simonwaid/particle_detector/20220615103611.md

Slide 2, line 2: SiC instead of Sic Next steps instead of Next Steps

Why does the CCE of iradiated samples not level off? Slide 11/12?

Slice 13 2.7 kHz
