simonwaid/particle_detector/xschem/comp/comp_amp_20db_no_cmm.pdf

# comp_amp_20db_no_cmm.sch

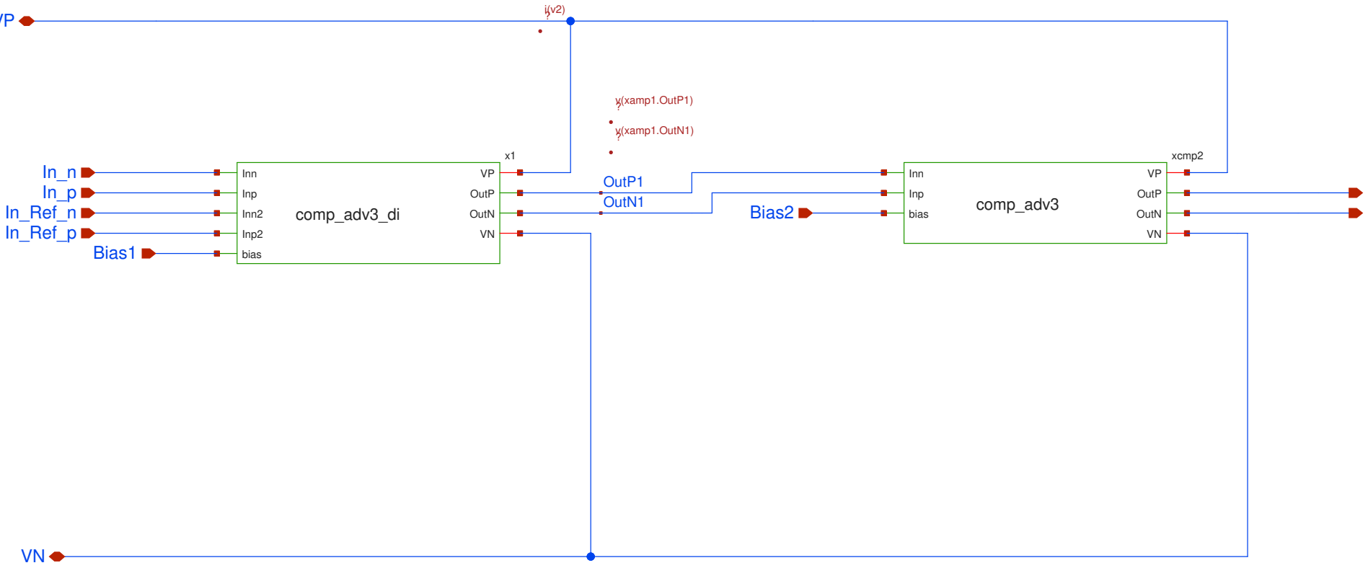
[picture p4: figure]
OutP1 OutN1; Bias1; Bias2; In_Ref_n In_Ref_p; v(xamp1.OutP1); v(xamp1.OutN1); comp_adv3; xcmp2; OutP; OutN; Inn; Inp; bias; comp_adv3_di; Inn2; Inp2

VP

# out_p out_n
