simonwaid/particle_detector/xschem/comp/comp_amp_di_40db_no_cmm.pdf

# comp_amp_di_40db_no_cmm.sch

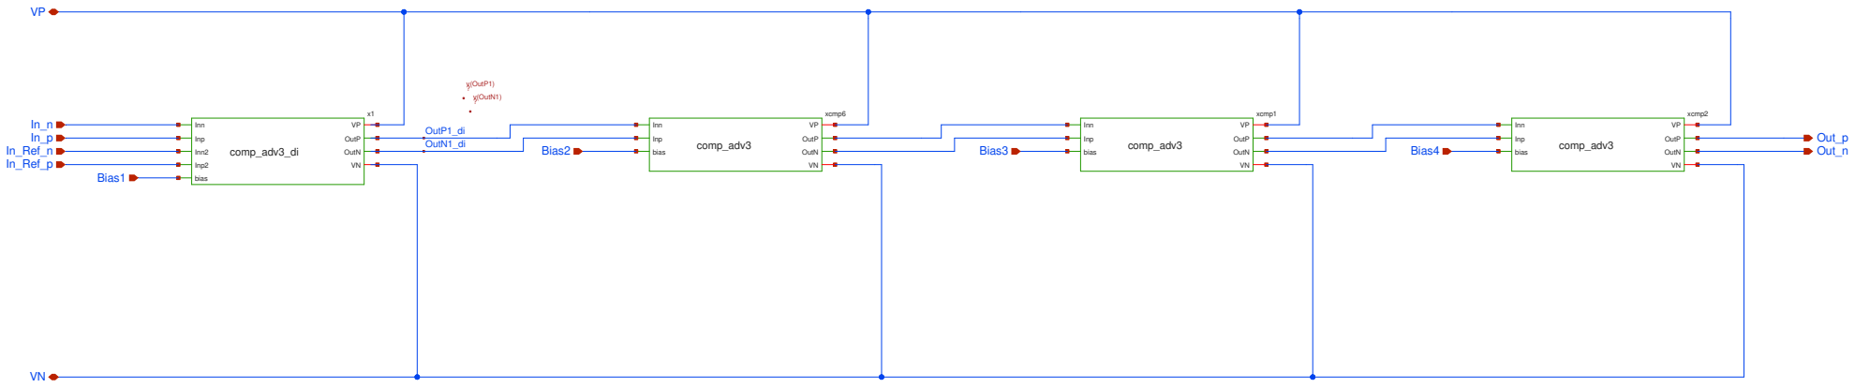
[picture p5: figure]
OutP1_di OutN1_di; Out_pIn_p; Bias1; Bias2; Out_nBias3; Bias4In_Ref_n; In_Ref_p; v(OutP1); v(OutN1); comp_adv3; xcmp6; OutP; OutN; Inn; Inp; bias; xcmp1; xcmp2; comp_adv3_di; Inn2; Inp2
