simonwaid/particle_detector/docs/source/blocks.png

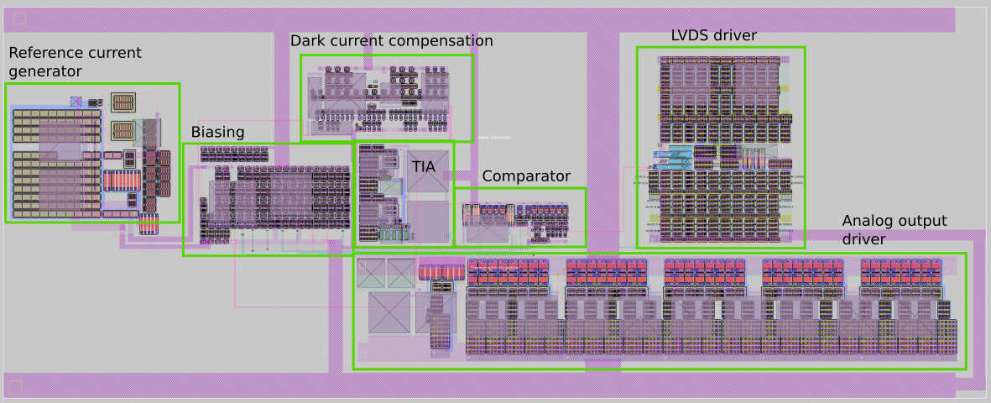
docs/source/blocks.png
