simonwaid/particle_detector/xschem/comp/comp.png

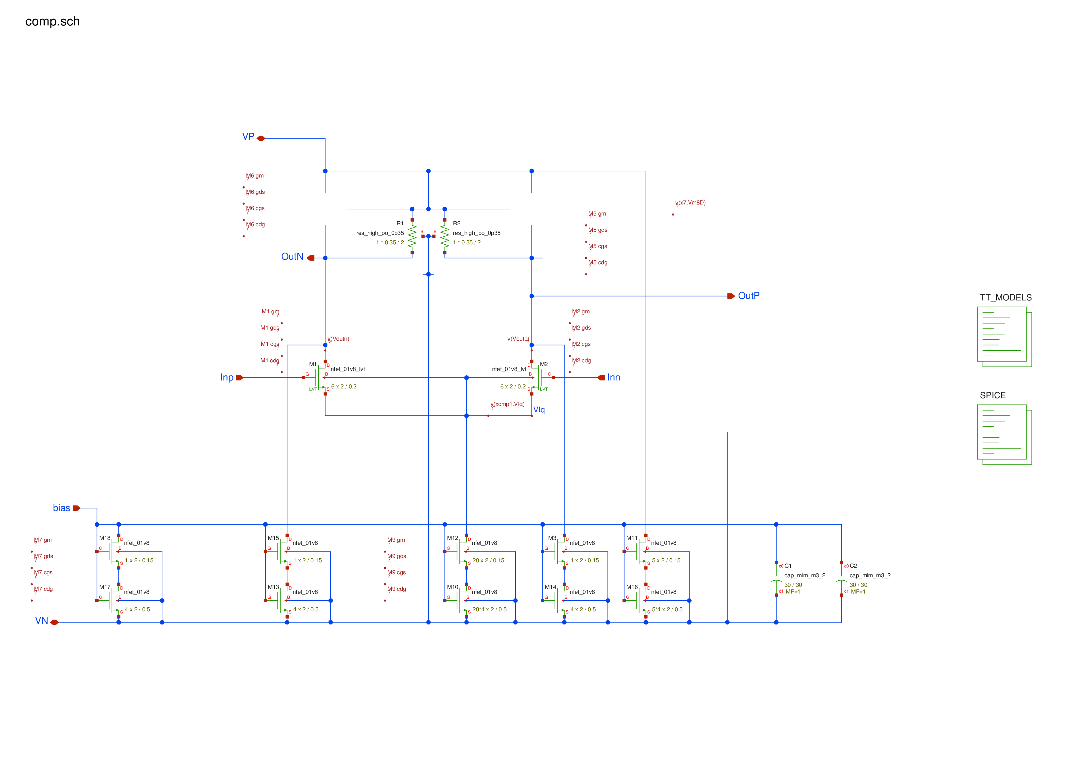
xschem/comp/comp.png
