simonwaid/particle_detector/xschem/comp/comp_adv2.png

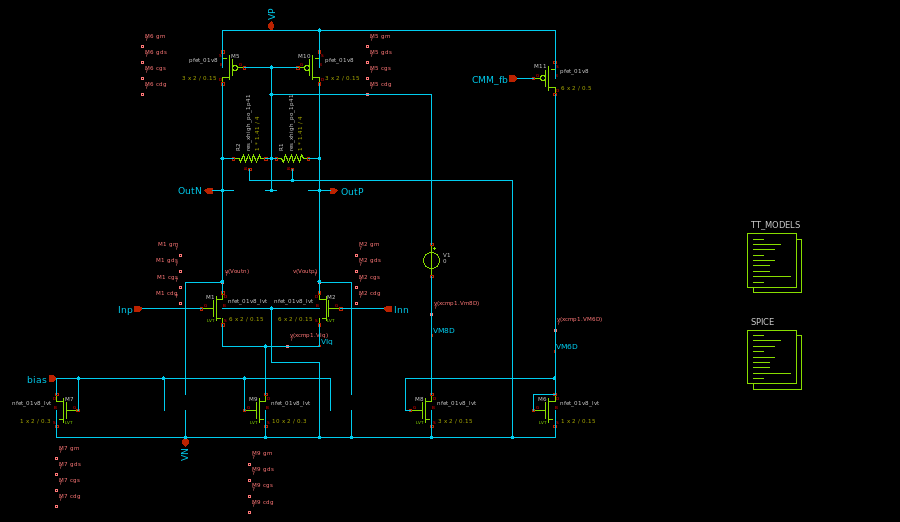
xschem/comp/comp_adv2.png
