simonwaid/particle_detector/xschem/comp/comp_adv3.png

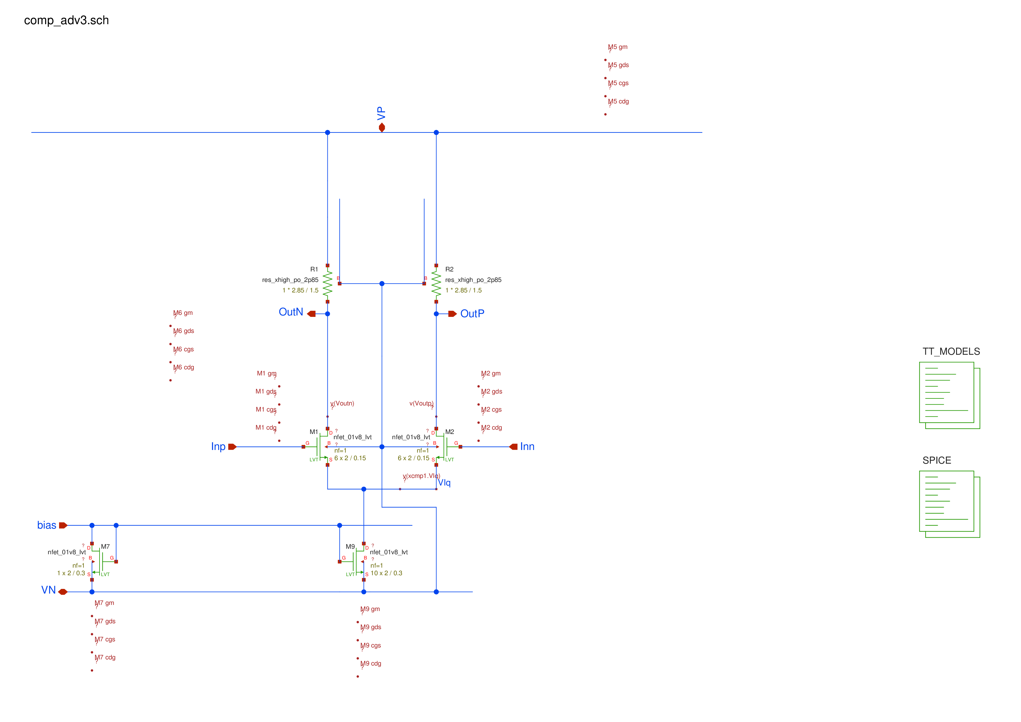
xschem/comp/comp_adv3.png
