simonwaid/particle_detector/xschem/comp/comp_adv3_di.png

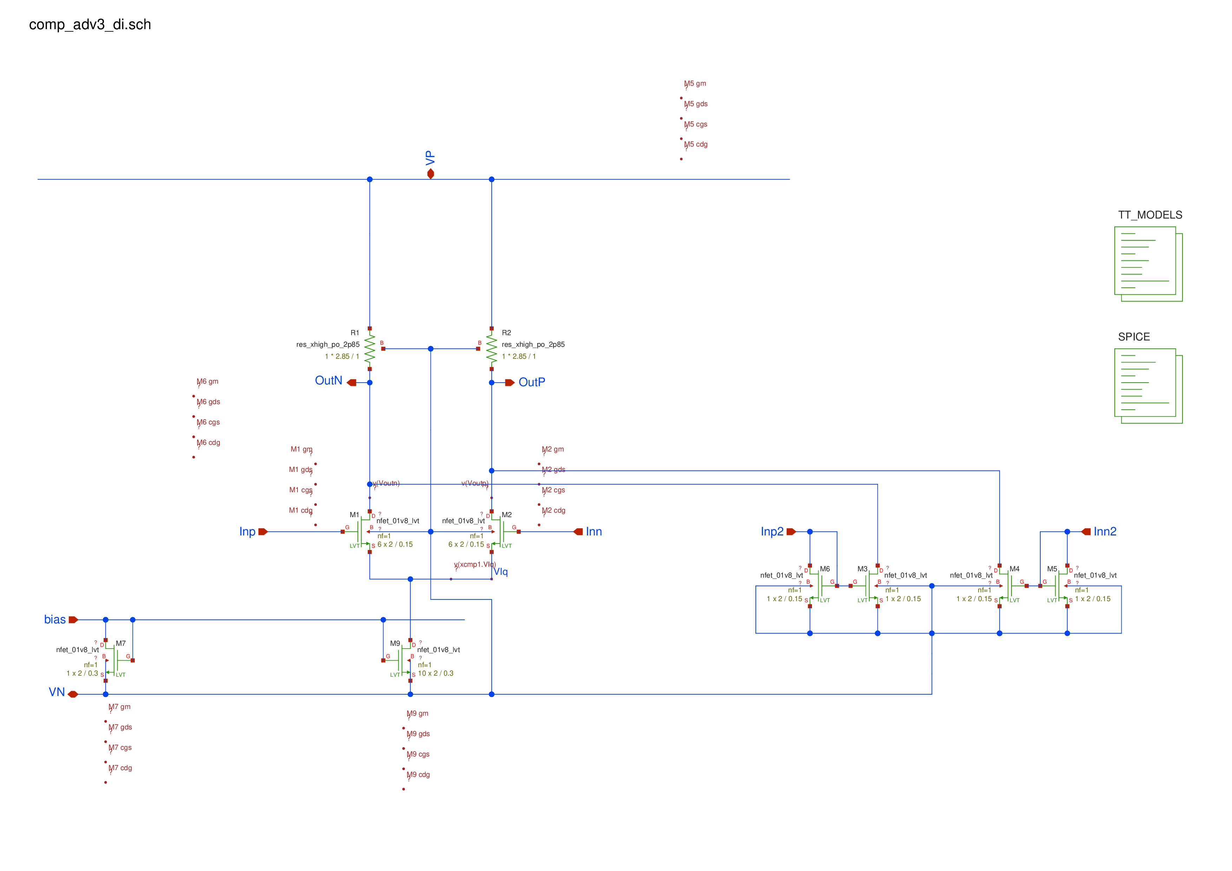
xschem/comp/comp_adv3_di.png
