simonwaid/particle_detector/xschem/comp/comp_adv.png

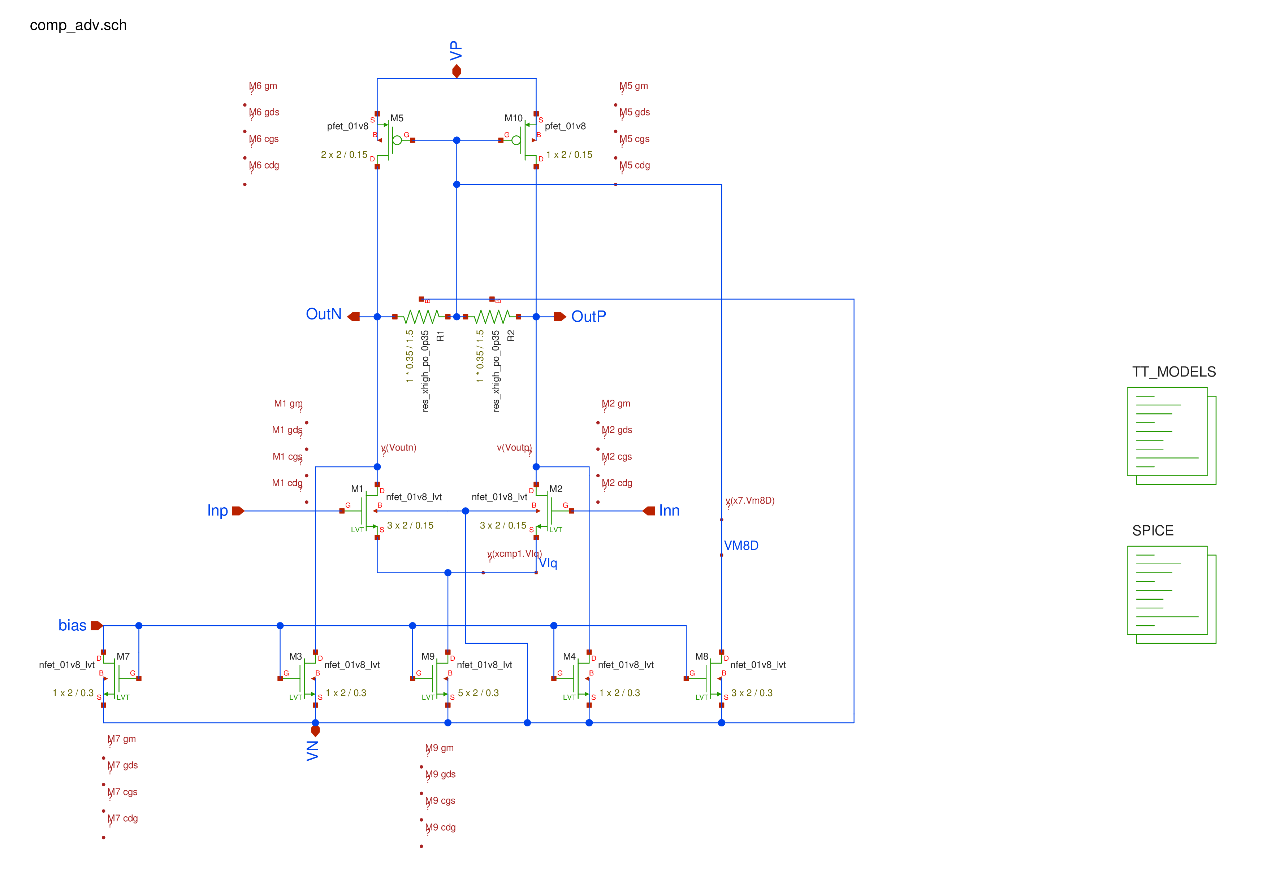
xschem/comp/comp_adv.png
