simonwaid/particle_detector/xschem/comp/comp_amp_20db.png

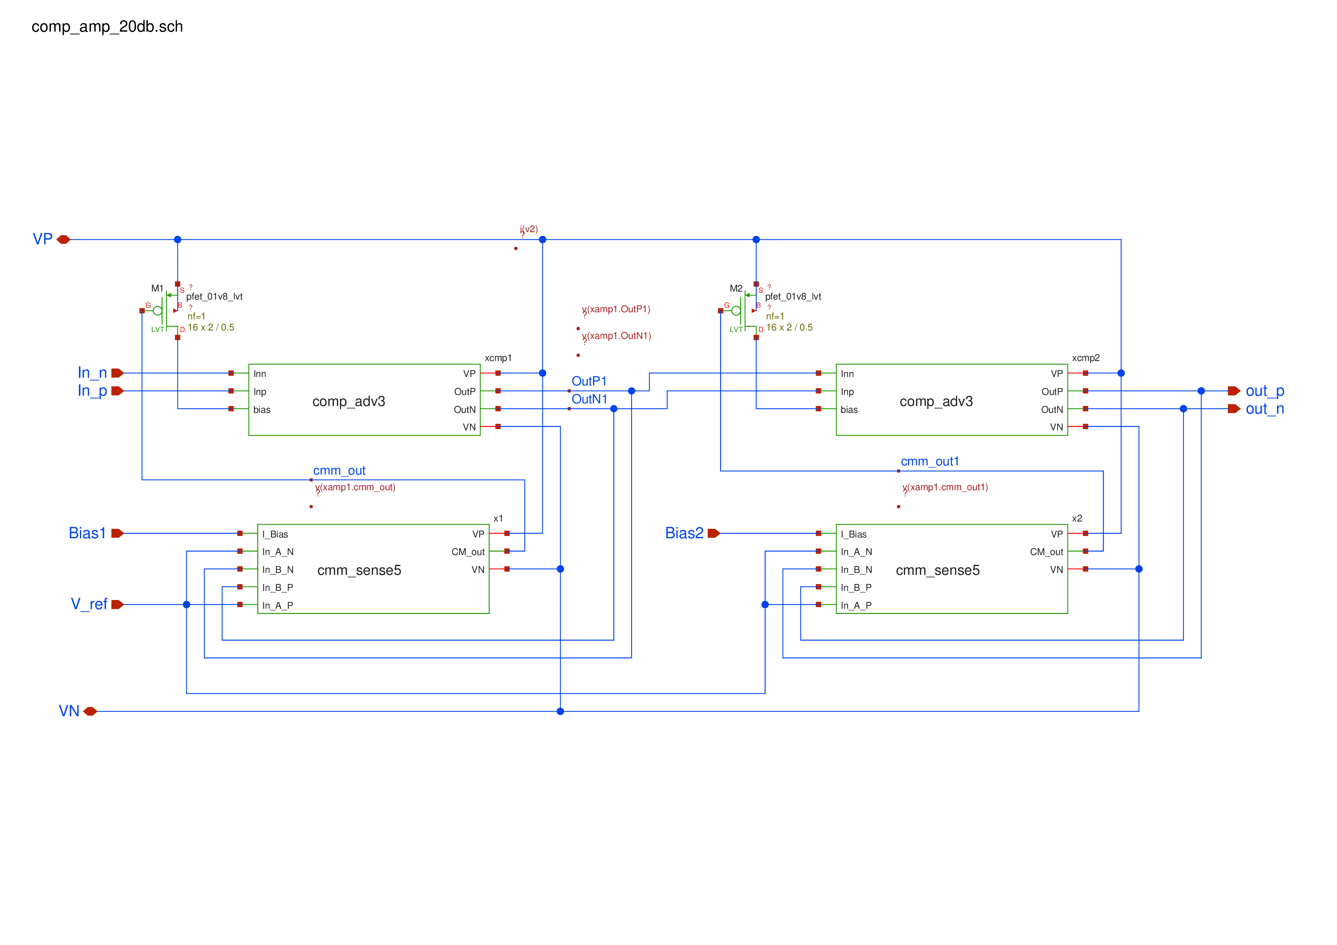
xschem/comp/comp_amp_20db.png
