simonwaid/particle_detector/xschem/comp/comp_amp_20db_no_cmm.png

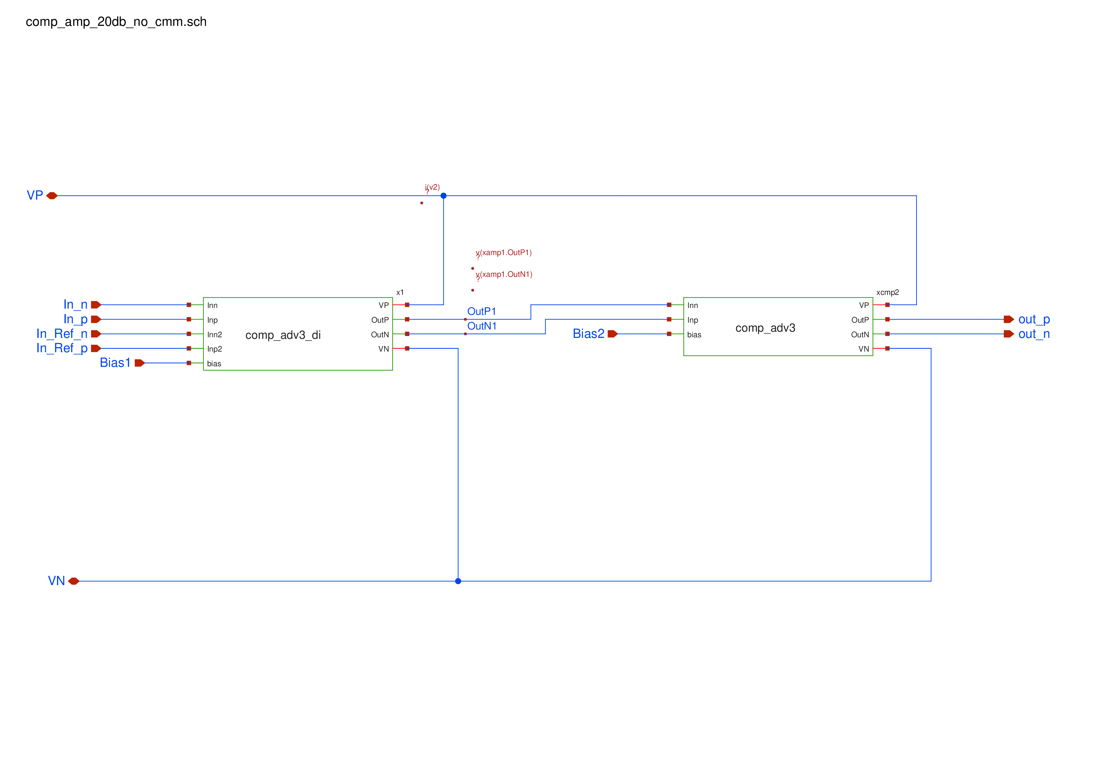
xschem/comp/comp_amp_20db_no_cmm.png
