simonwaid/particle_detector/xschem/comp/comp_amp_di_40db.png

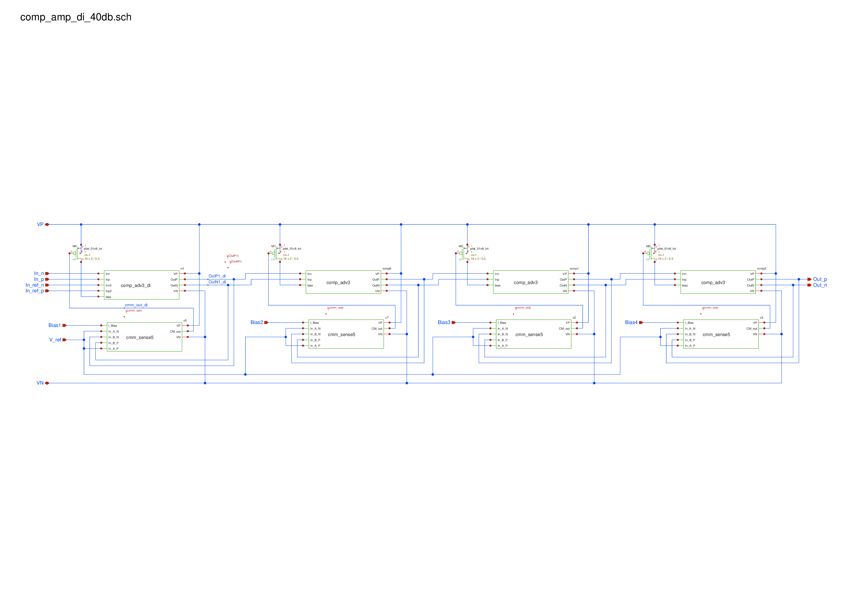
xschem/comp/comp_amp_di_40db.png
