simonwaid/particle_detector/xschem/comp/comp_amp_di_40db_no_cmm.png

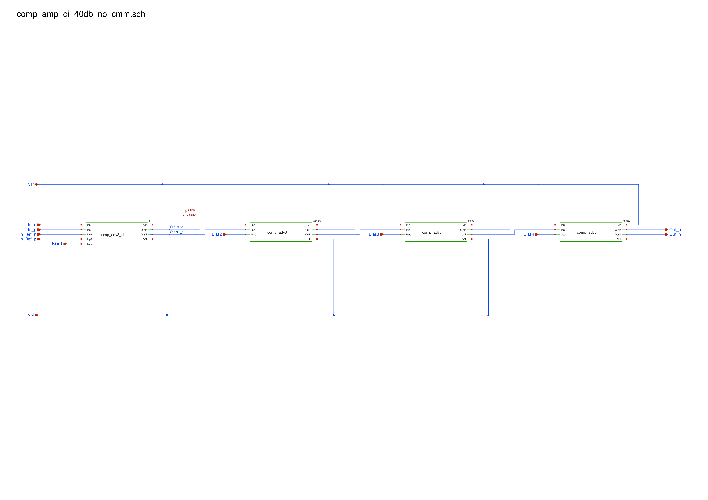
xschem/comp/comp_amp_di_40db_no_cmm.png
