simonwaid/particle_detector/xschem/comp/comp_casc2.png

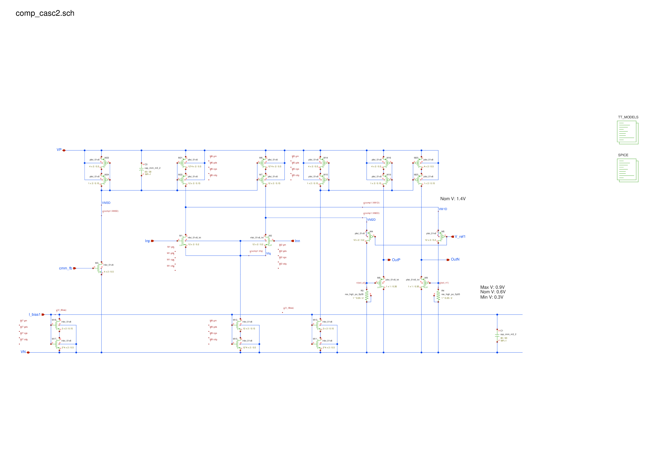
xschem/comp/comp_casc2.png
