simonwaid/particle_detector/xschem/comp/comp_casc.png

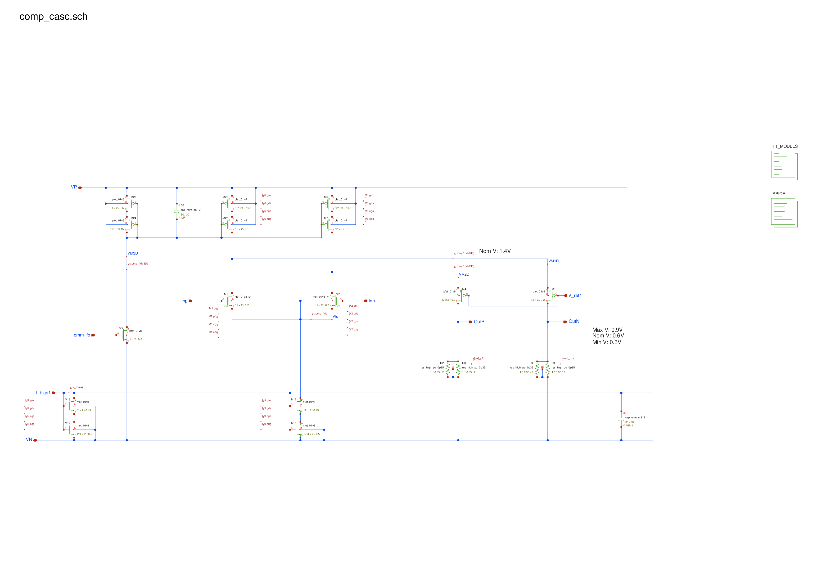
xschem/comp/comp_casc.png
