simonwaid/particle_detector/xschem/comp/comp_casc_p.png

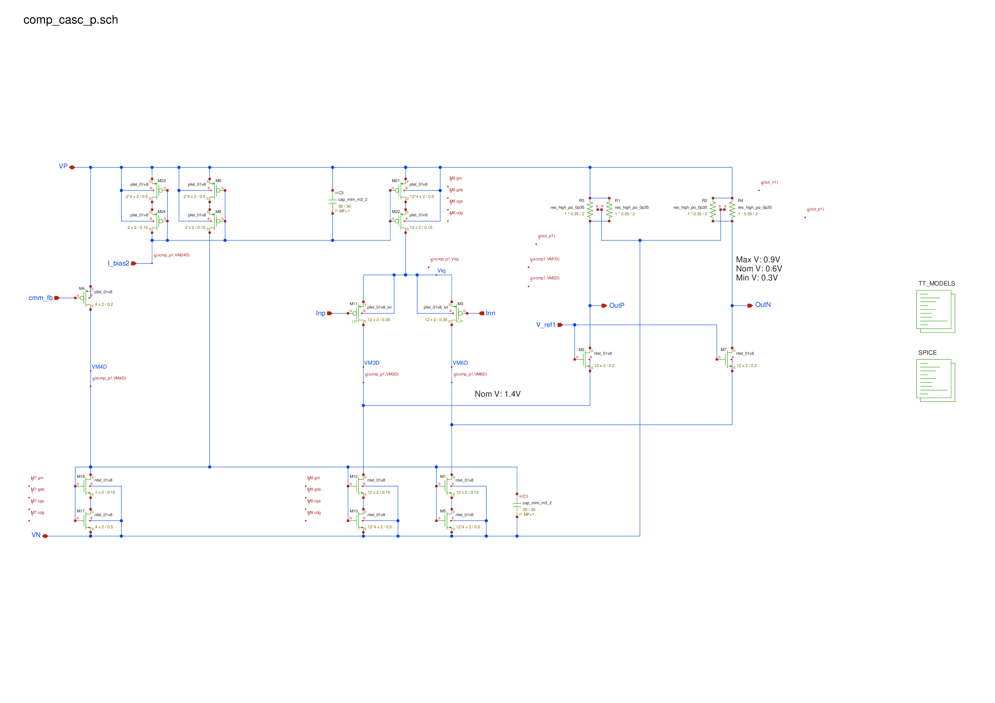
xschem/comp/comp_casc_p.png
