simonwaid/particle_detector/xschem/comp/comp_complete.png

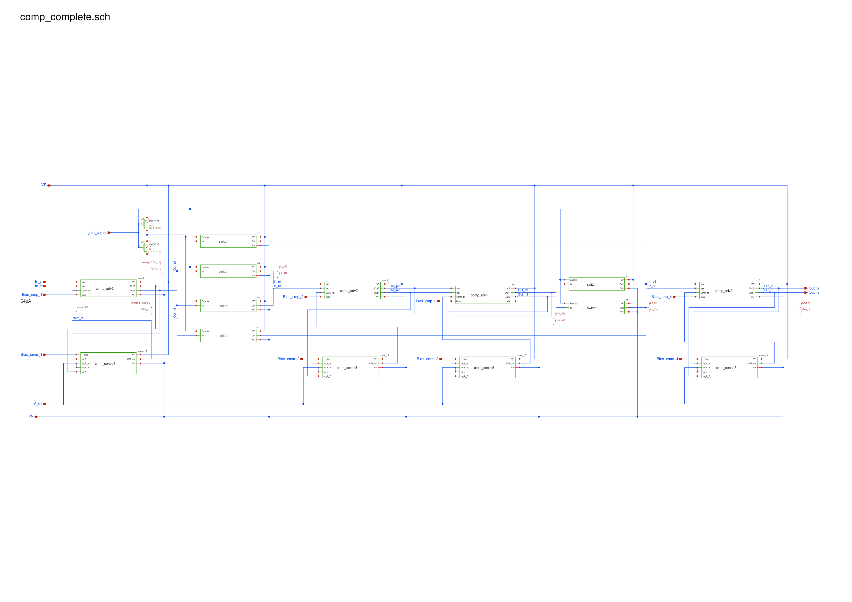
xschem/comp/comp_complete.png
