simonwaid/particle_detector/xschem/comp/comp_to_logic.png

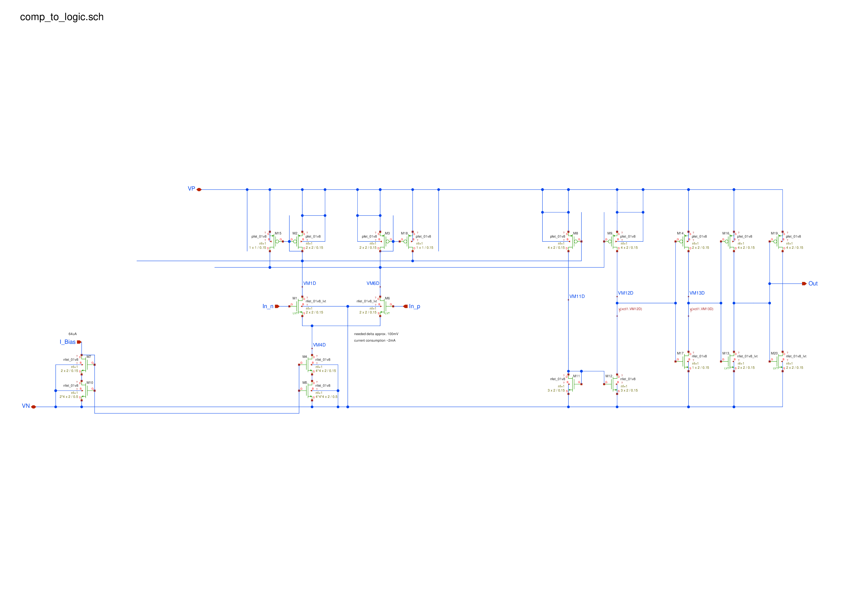
xschem/comp/comp_to_logic.png
