simonwaid/particle_detector/xschem/comp/compEn.png

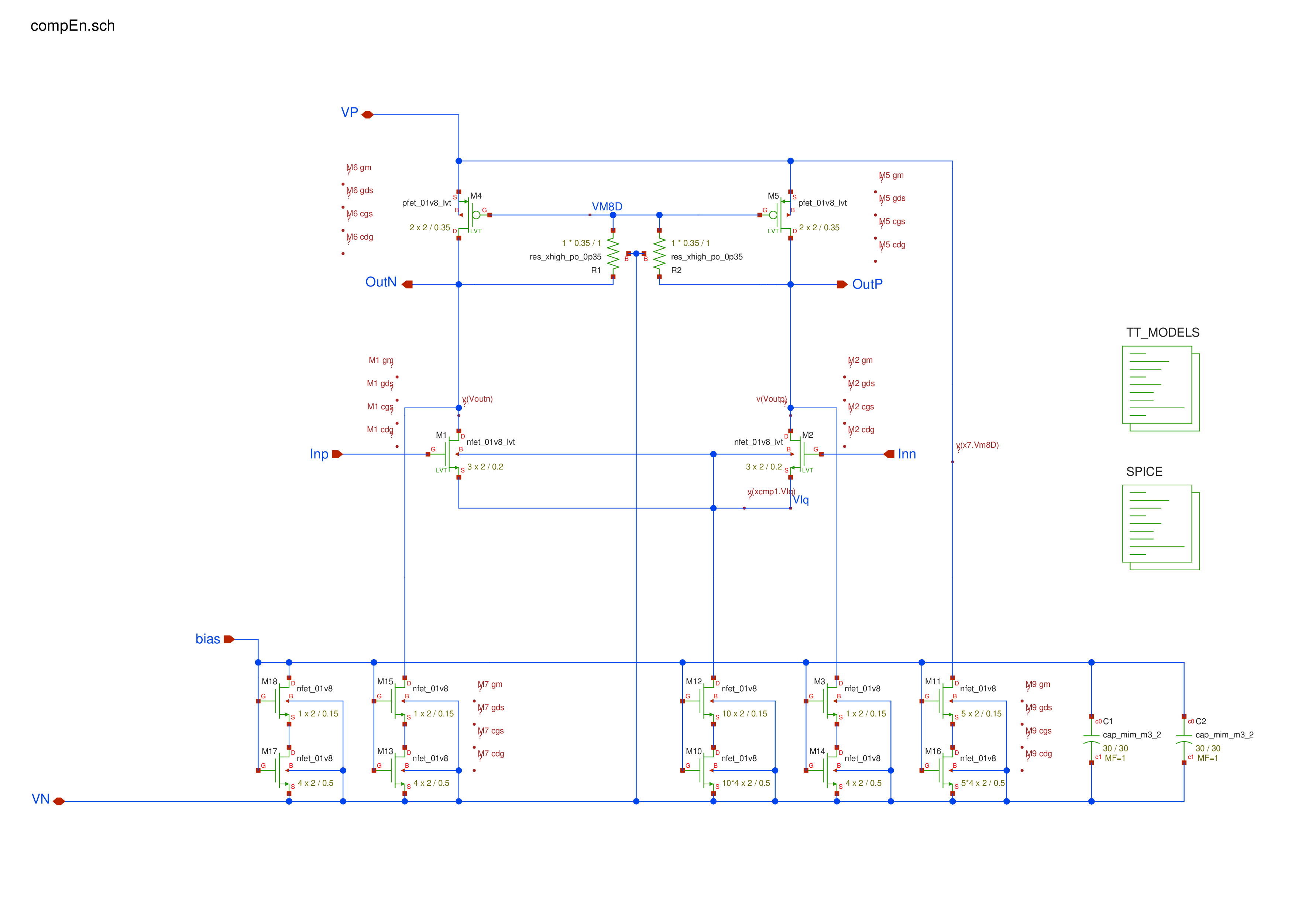
xschem/comp/compEn.png
