simonwaid/particle_detector/xschem/comp/osch.png

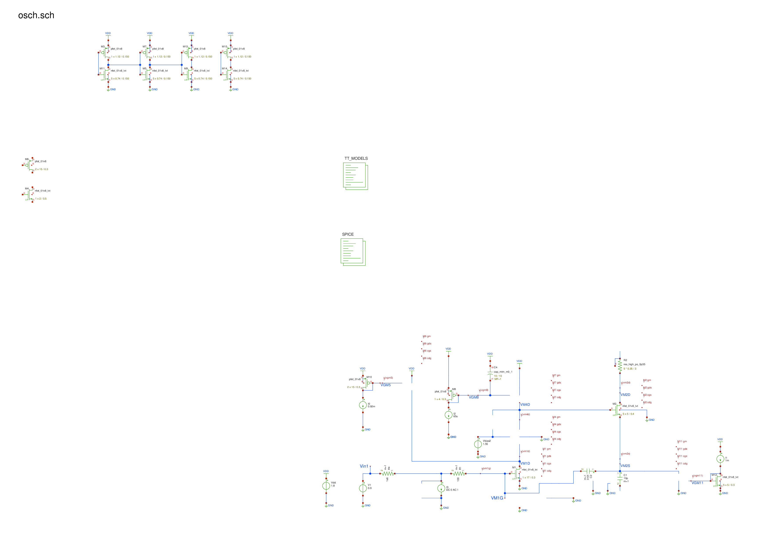
xschem/comp/osch.png
