simonwaid/particle_detector/xschem/comp/switch.png

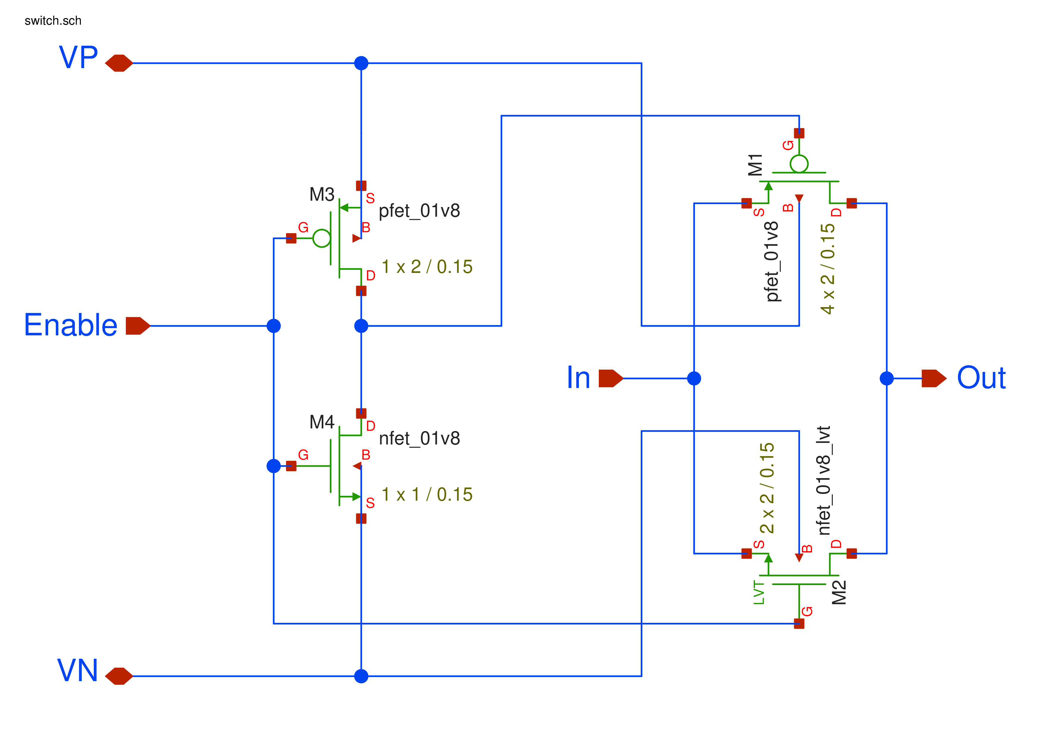
xschem/comp/switch.png
