simonwaid/particle_detector/xschem/comp/result_op.csv

 vdd             vdd#branch
 1.80000000e+00 -1.28275264e-04
