simonwaid/particle_detector/xschem/final_test/tran_tia1/tran_UB_[1.7]_v(tia1_outn)_small.png

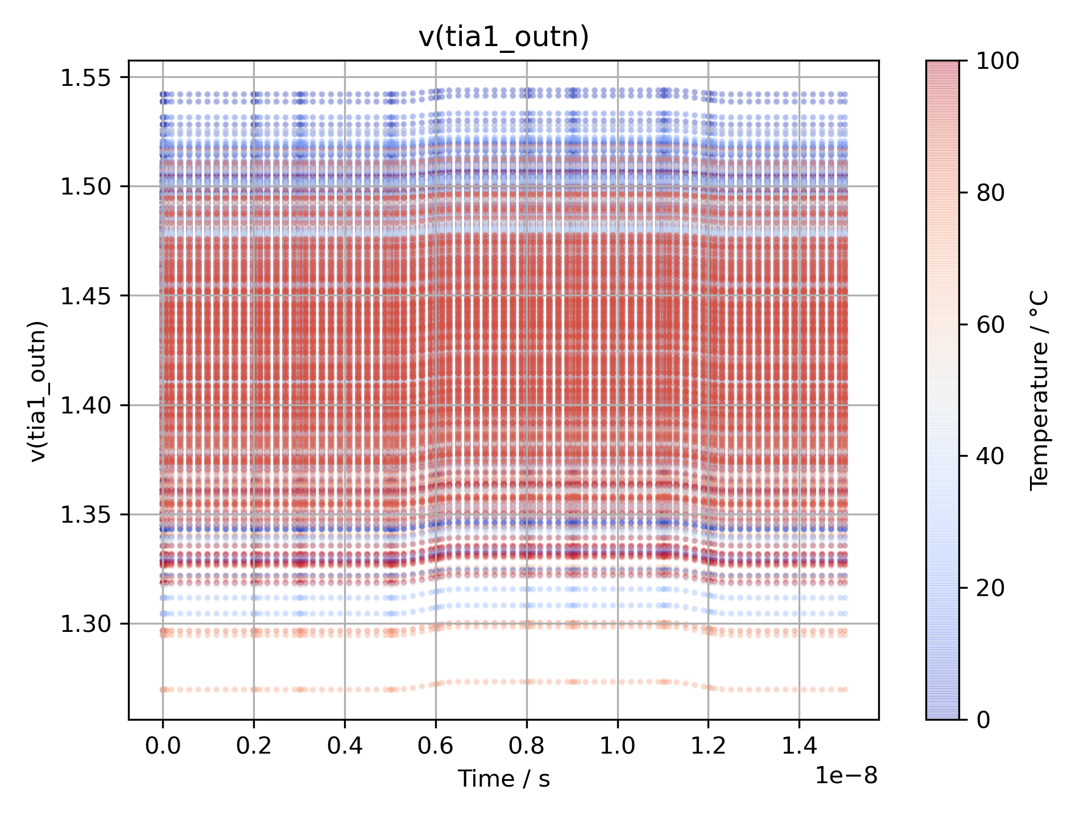
xschem/final_test/tran_tia1/tran_UB_[1.7]_v(tia1_outn)_small.png
