simonwaid/particle_detector/xschem/final_test/tran_tia2/tran_UB_[1.7]_v(tia2_outp)_small.png

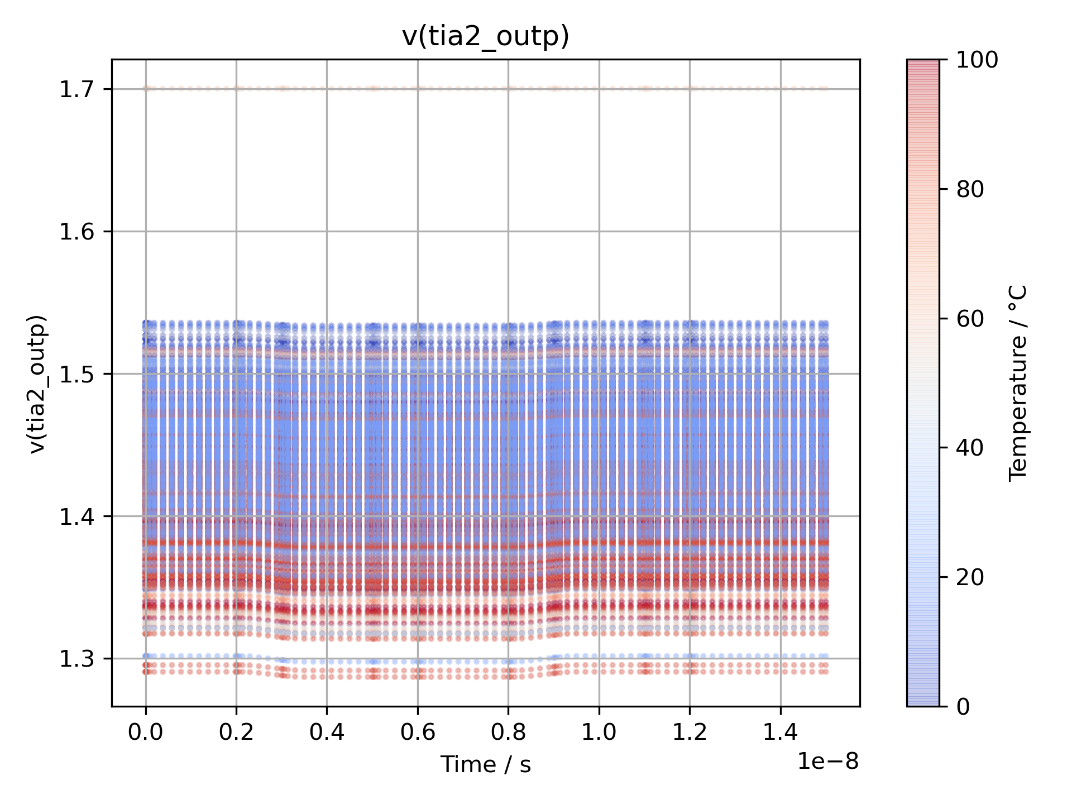
xschem/final_test/tran_tia2/tran_UB_[1.7]_v(tia2_outp)_small.png
