simonwaid/particle_detector/xschem/comp/comp_casc.pdf

# comp_casc.sch

## TT_MODELS

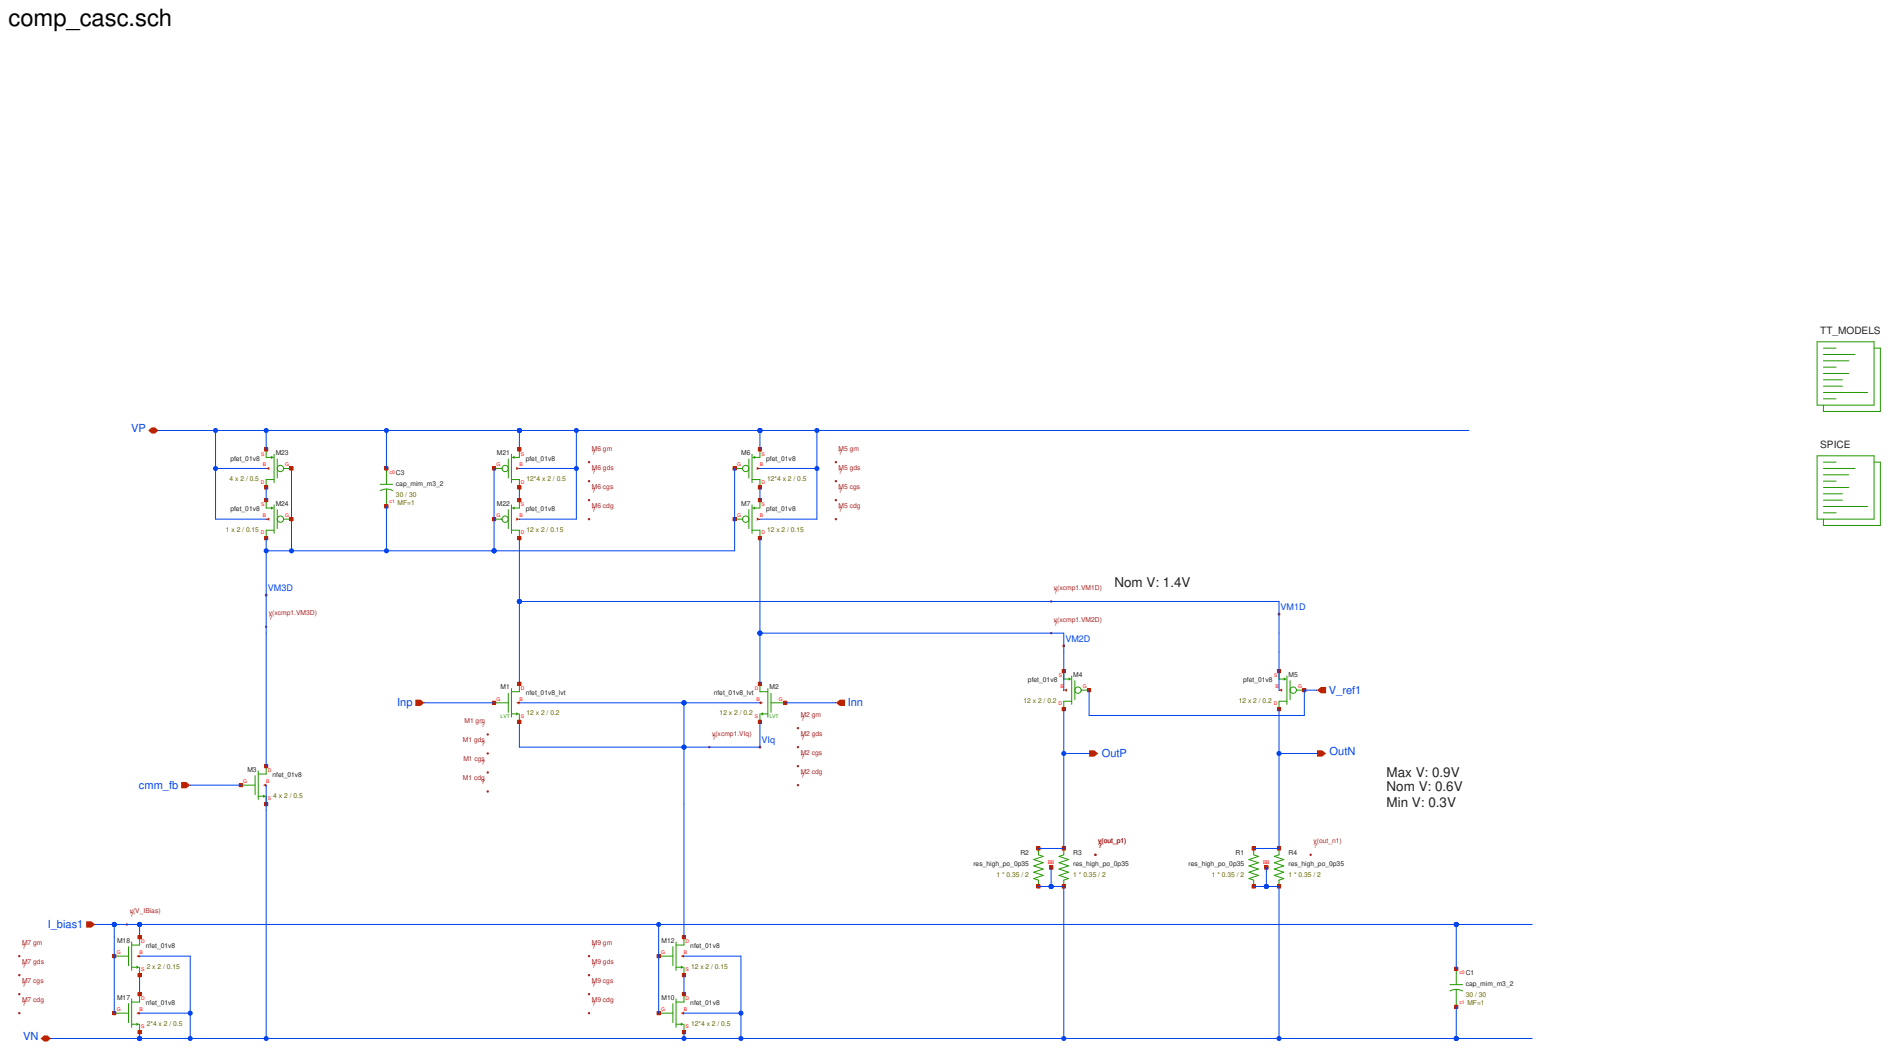
[picture p34: page 1]
Nom V: 1.4V; Max V: 0.9V Nom V: 0.6V Min V: 0.3V; VIq; Inp; I_bias1; Inn; OutP; OutN; V_ref1; cmm_fb; M5 gds; M5 cgs; M5 cdg; SPICE; nfet_01v8_lvt; 12 x 2 / 0.2 LVT; LVT; M6 gds; M6 cgs; M6 cdg; M2 gds; M2 cgs; M2 cdg; M1 gds; M1 cgs; M1 cdg; M9 gds; M9 cgs; M9 cdg; M7 gds; M7 cgs; M7 cdg; v(xcmp1.VIq); nfet_01v8; cap_mim_m3_2; pfet_01v8; res_high_po_0p35 B; v(xcmp1.VM2D); v(xcmp1.VM1D); v(out_p1); v(out_n1); v(xcmp1.VM3D); v(V_IBias); res_high_po_0p35
