simonwaid/particle_detector/xschem/comp/comp_casc_p.pdf

# comp_casc_p.sch

VP

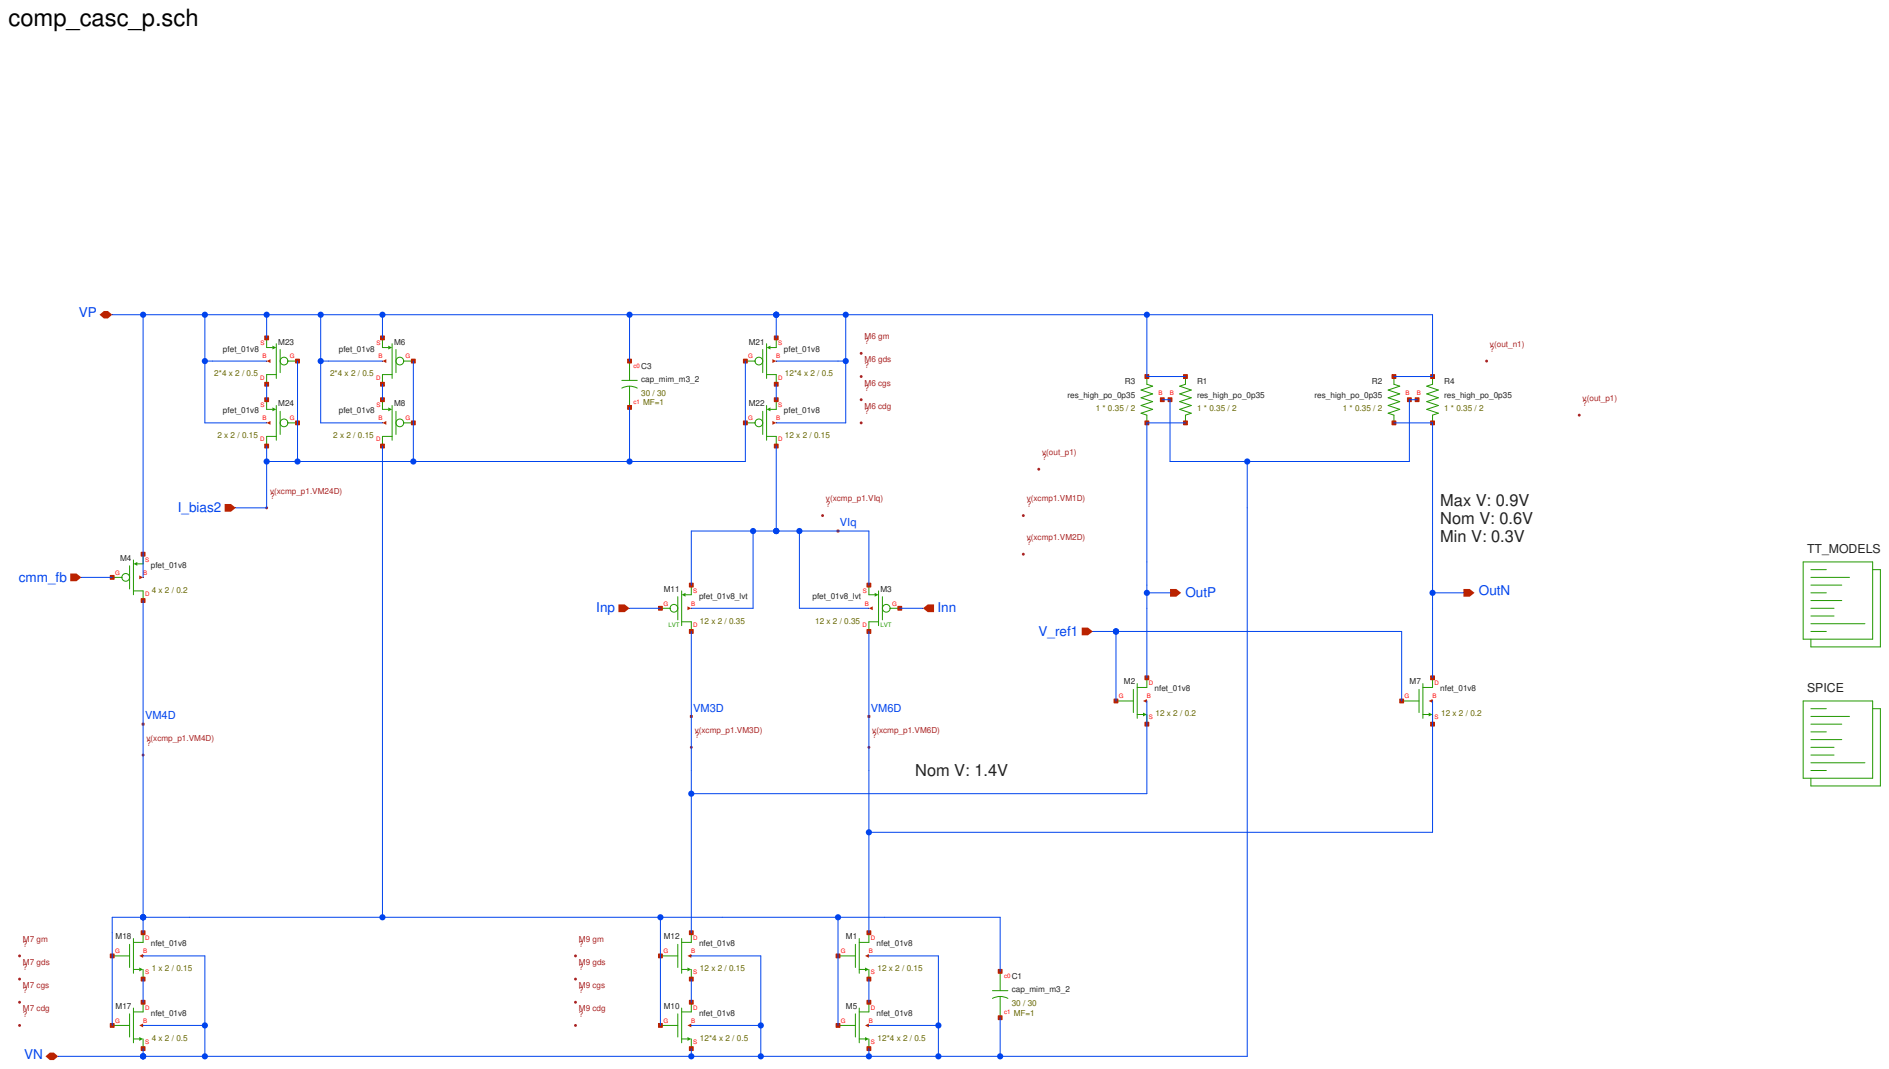
[picture p35: page 1]
Nom V: 1.4V; Max V: 0.9V Nom V: 0.6V Min V: 0.3V; VIq; Inp; cmm_fb; Inn; OutP; OutN; V_ref1; I_bias2; TT_MODELS; SPICE; M6 gds; M6 cgs; M6 cdg; M9 gds; M9 cgs; M9 cdg; M7 gds; M7 cgs; M7 cdg; v(xcmp_p1.VIq); nfet_01v8; cap_mim_m3_2; res_high_po_0p35; res_high_po_0p35 B; v(xcmp1.VM2D); v(xcmp1.VM1D); v(out_p1); v(out_n1); pfet_01v8; v(xcmp_p1.VM3D); v(xcmp_p1.VM6D); v(xcmp_p1.VM4D); LVT; pfet_01v8_lvt; v(xcmp_p1.VM24D)
