simonwaid/particle_detector/xschem/comp/comp_to_logic.pdf

# comp_to_logic.sch

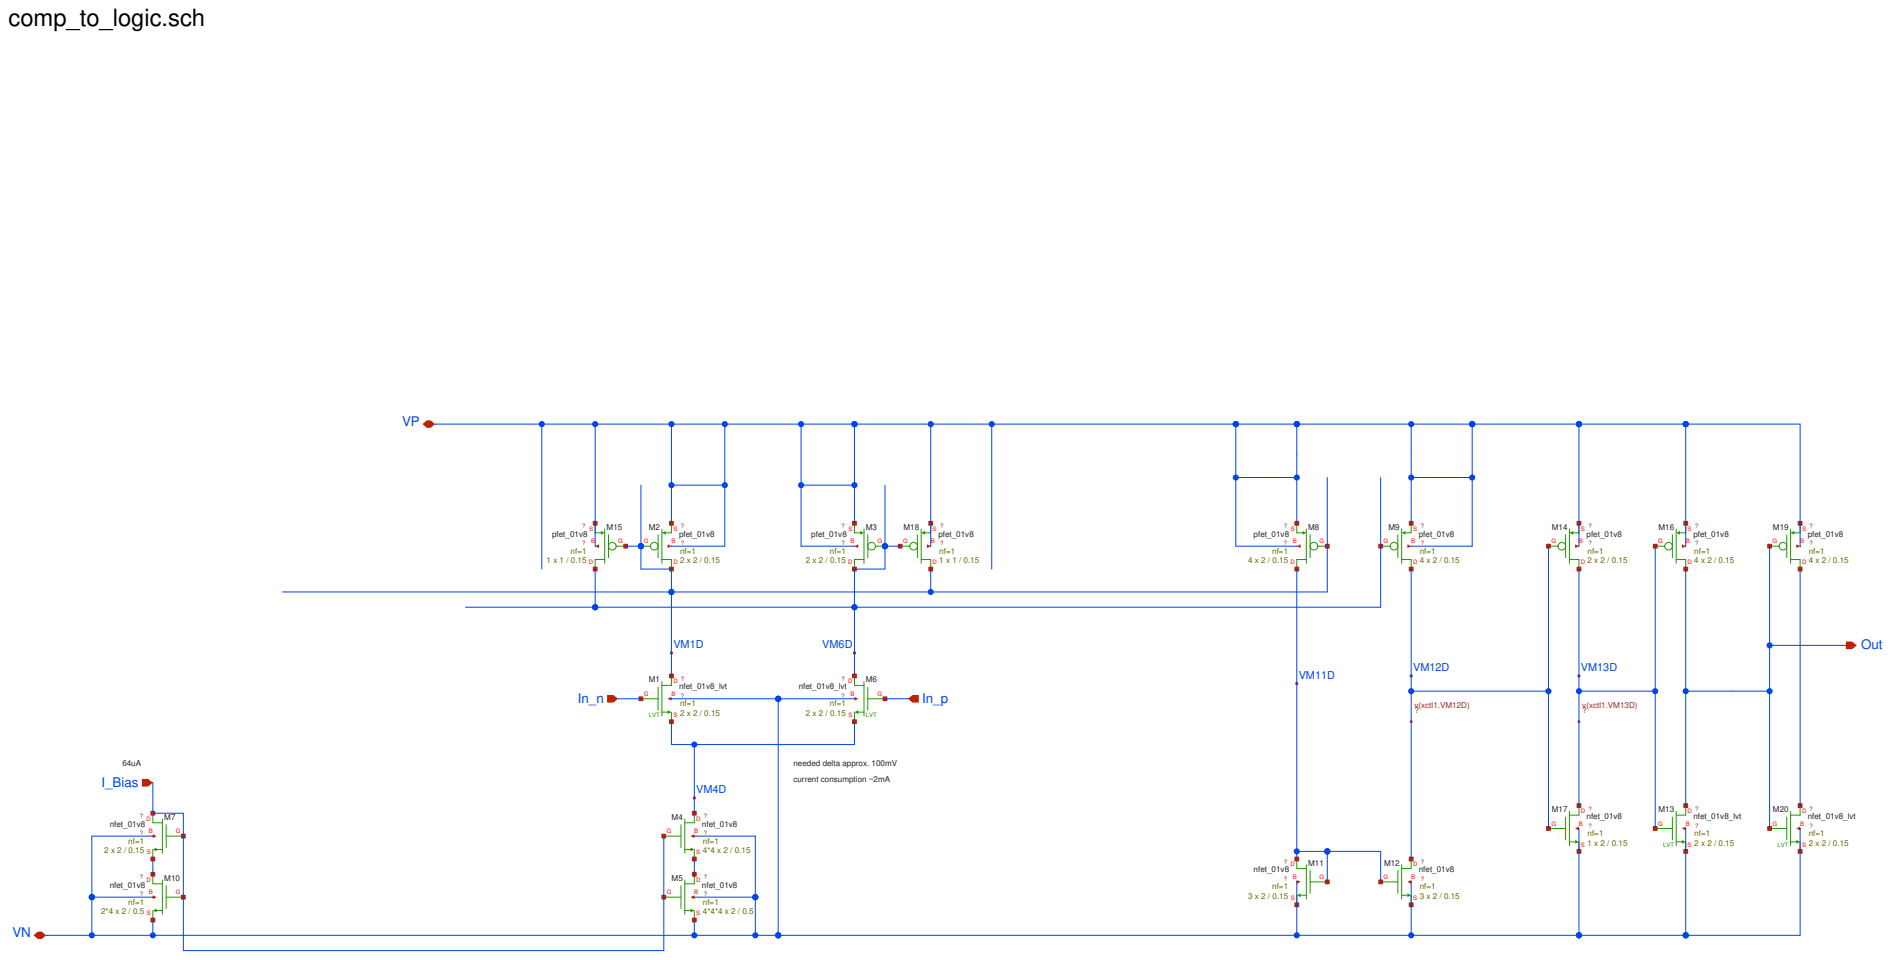
[picture p36: page 1]
needed delta approx. 100mV; current consumption ~2mA; In_pIn_n; I_Bias; Out; nfet_01v8_lvt; LVT; pfet_01v8; nfet_01v8; v(xctl1.VM12D); v(xctl1.VM13D)
