simonwaid/particle_detector/xschem/comp/switch.pdf

VP

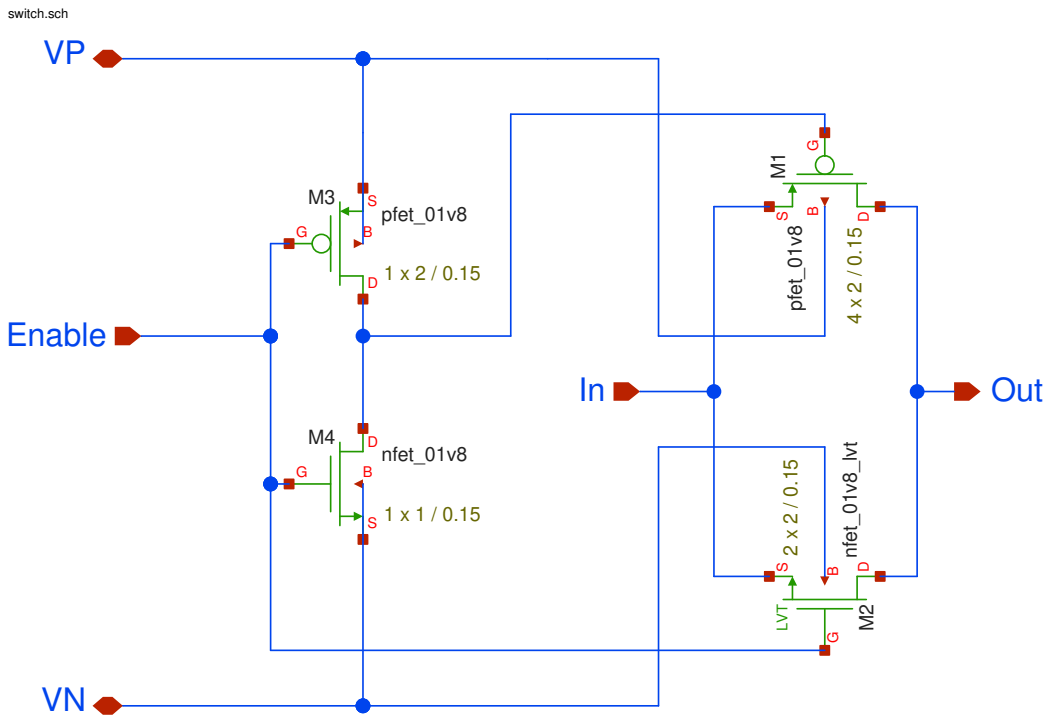
[picture p37: page 1]
switch.sch; Enable; Out; pfet_01v8; nfet_01v8; nfet_01v8_lvt; LVT
