simonwaid/particle_detector/xschem/comp/comp.pdf

# comp.sch

VP

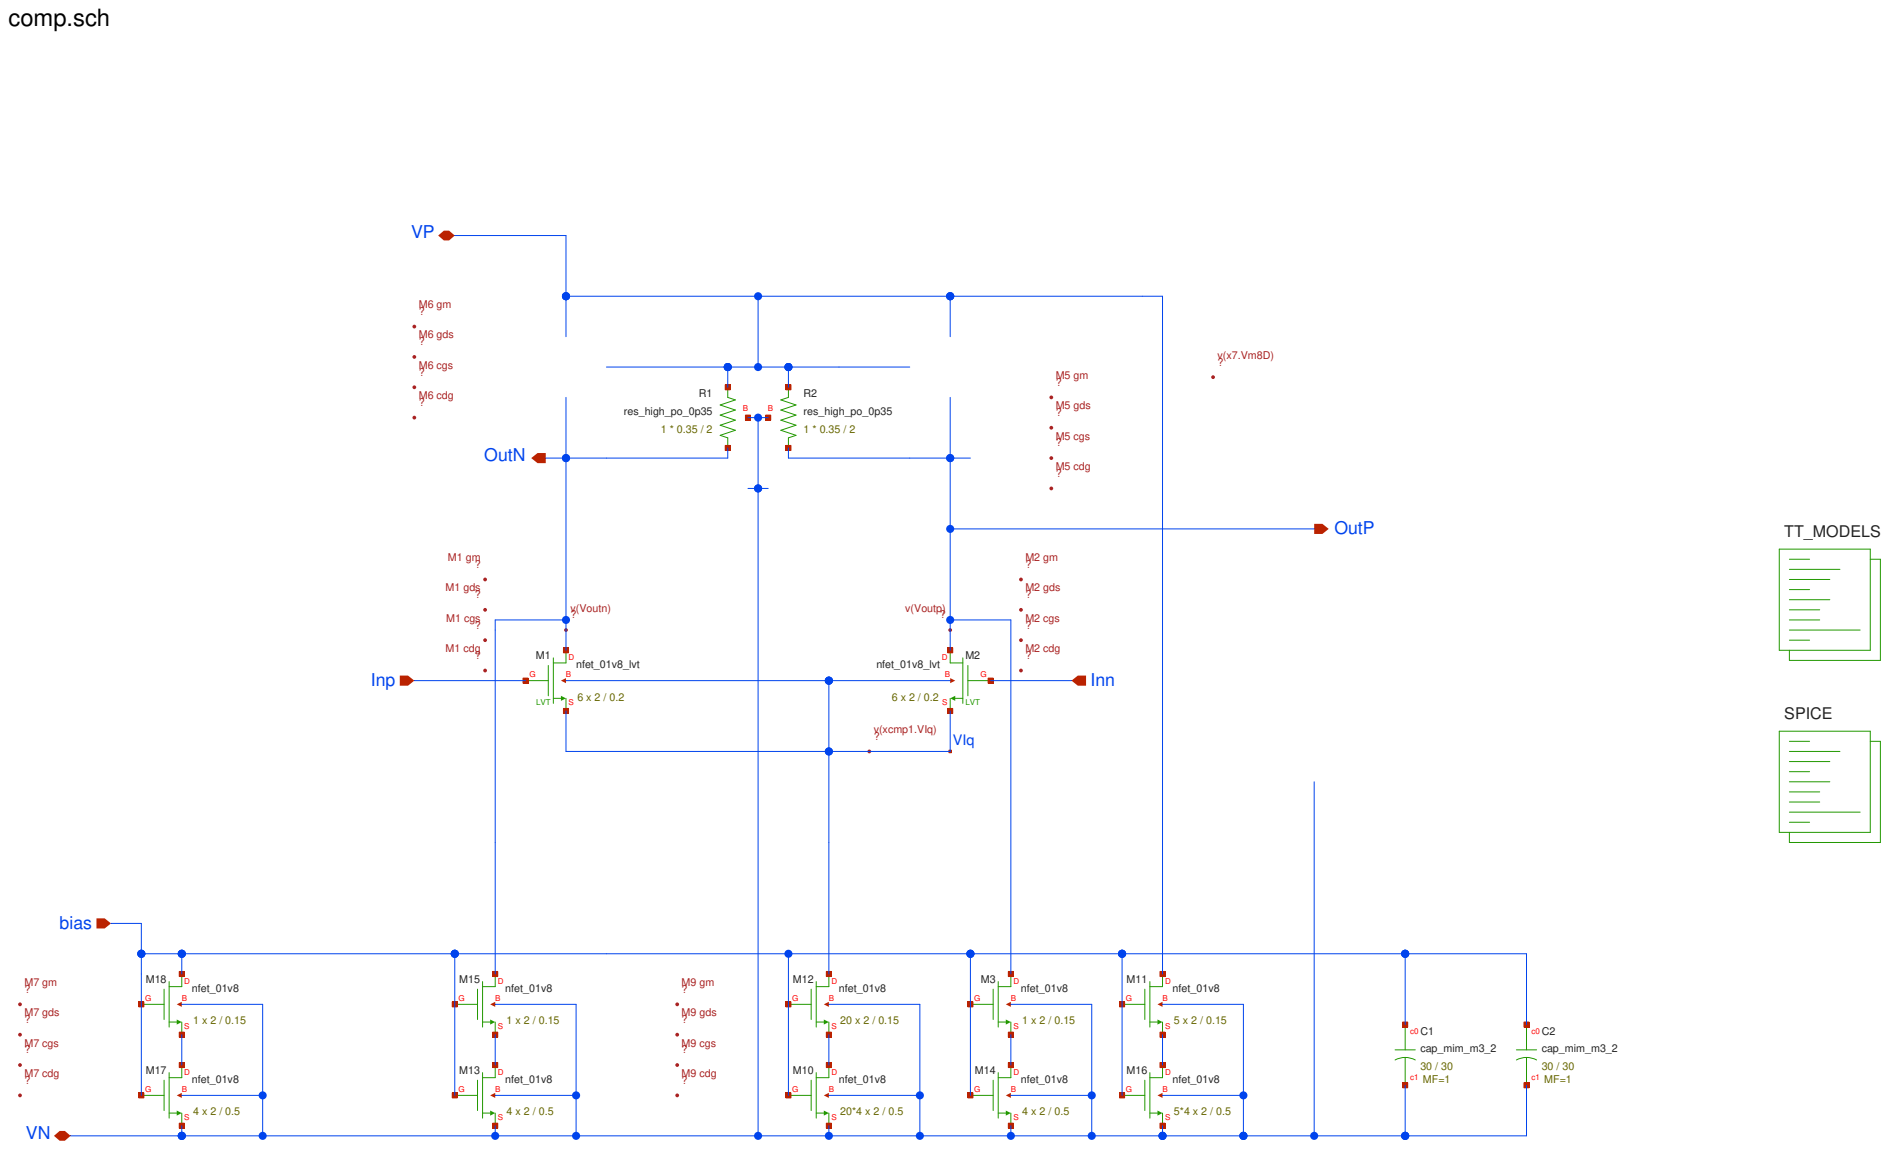
[picture p38: page 1]
VIq; Inp; bias; Inn; OutN; OutP; TT_MODELS; M5 gds; M5 cgs; M5 cdg; SPICE; nfet_01v8_lvt; 6 x 2 / 0.2 LVT; LVT; M6 gds; M6 cgs; M6 cdg; M2 gds; M2 cgs; M2 cdg; M1 gds; M1 cgs; M1 cdg; M9 gds; M9 cgs; M9 cdg; M7 gds; M7 cgs; M7 cdg; v(Voutn); v(Voutp); v(xcmp1.VIq); nfet_01v8; cap_mim_m3_2; res_high_po_0p35; res_high_po_0p35 B
