simonwaid/particle_detector/xschem/comp/comp_adv.pdf

## comp_adv.sch

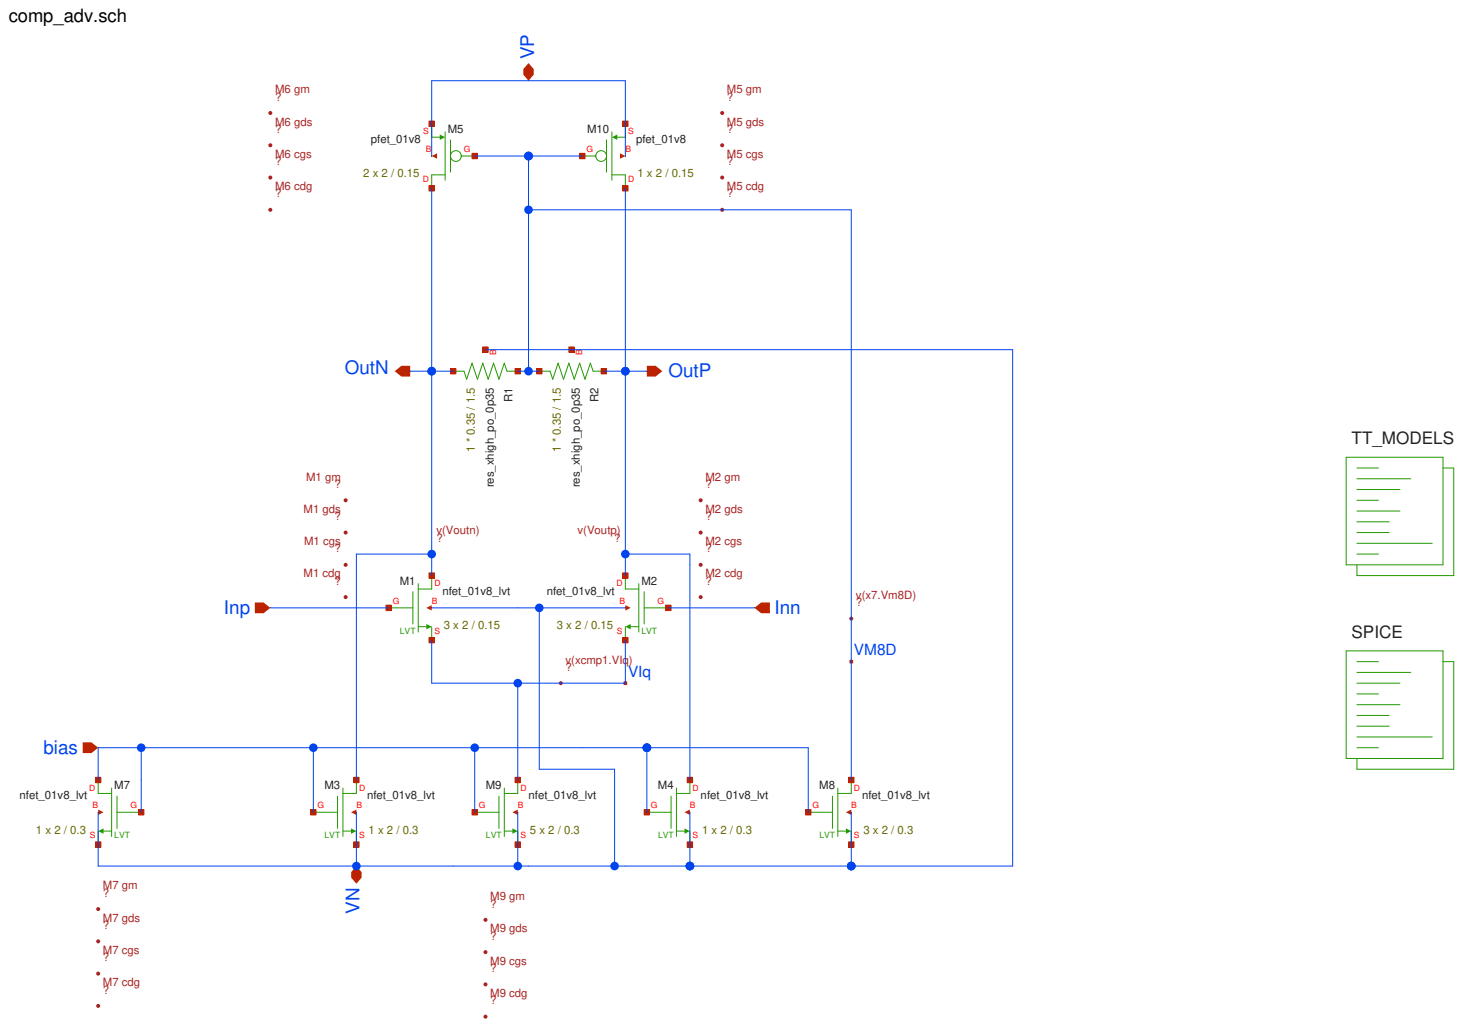
[picture p39: page 1]
VIq; Inp; bias; Inn; OutN; OutP; TT_MODELS; M5 gds; M5 cgs; M5 cdg; SPICE; nfet_01v8_lvt; 3 x 2 / 0.15 LVT; LVT; 1 x 2 / 0.3 LVT; M6 gds; M6 cgs; M6 cdg; M2 gds; M2 cgs; M2 cdg; 5 x 2 / 0.3 LVT; M1 gds; M1 cgs; M1 cdg; M9 gds; M9 cgs; M9 cdg; M7 gds; M7 cgs; M7 cdg; v(Voutn); v(Voutp); v(xcmp1.VIq); 3 x 2 / 0.3 LVT; pfet_01v8; res_xhigh_po_0p35 B
