simonwaid/particle_detector/xschem/comp/comp_adv2.pdf

# comp_adv2.sch

## CMM_fb

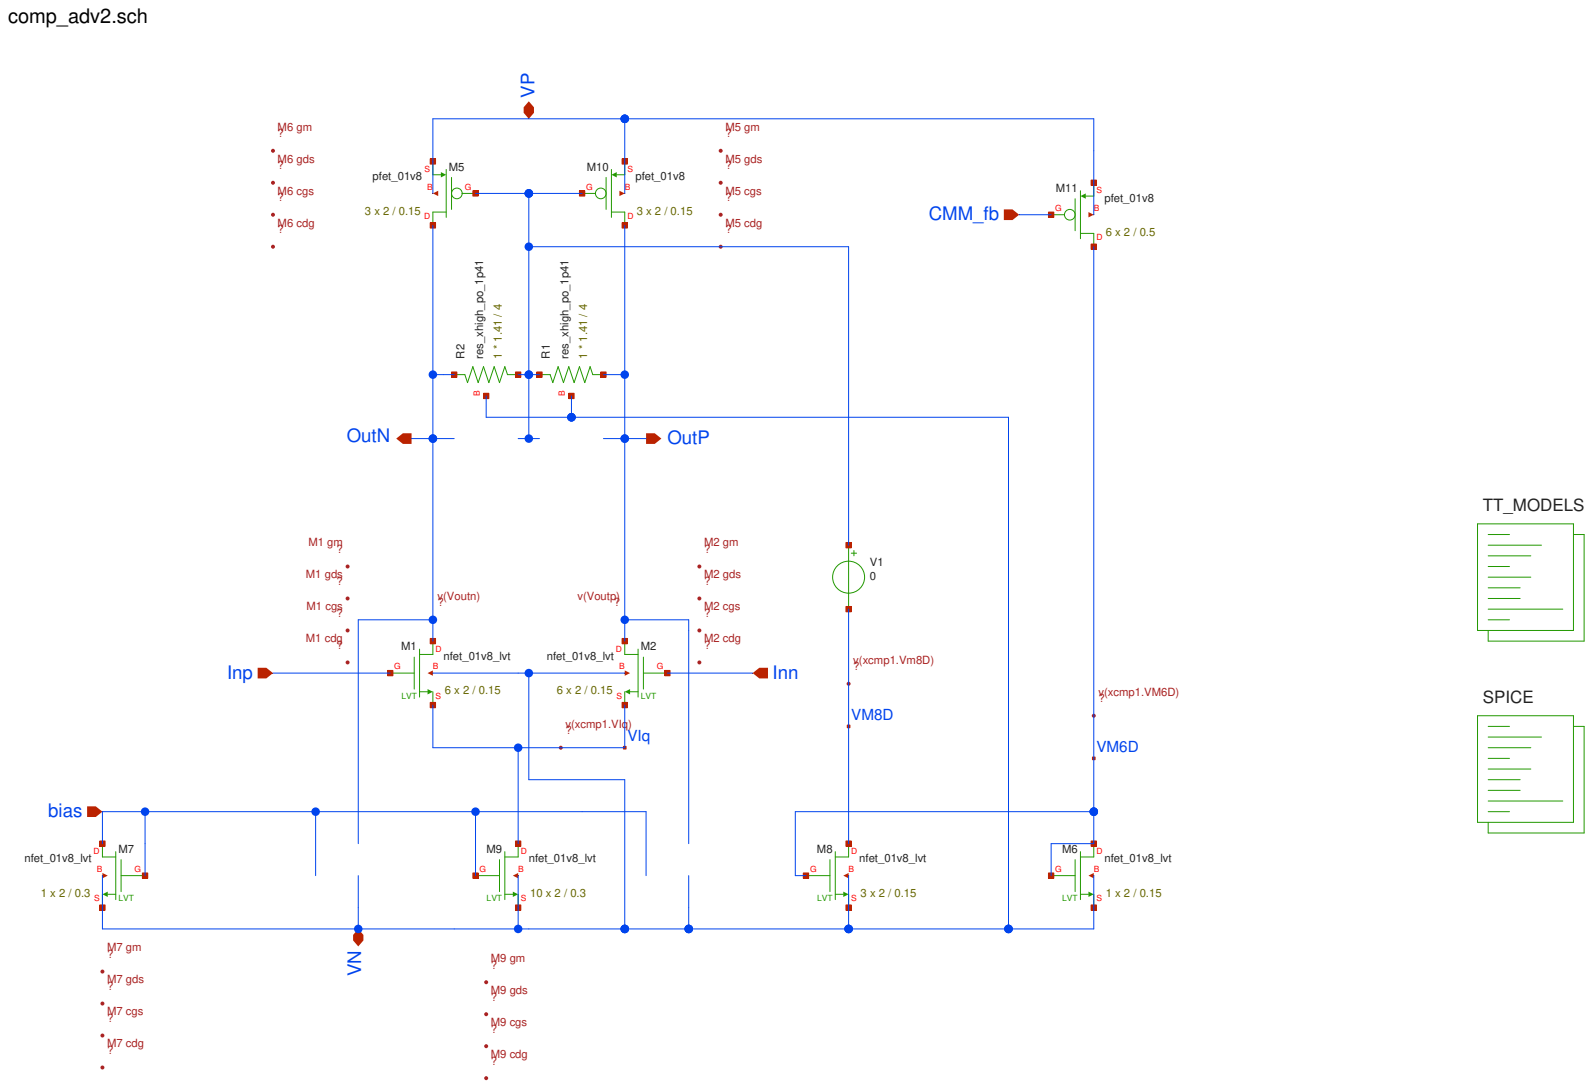
[picture p40: page 1]
VIq; Inp; bias; Inn; OutN; OutP; TT_MODELS; M5 gds; M5 cgs; M5 cdg; SPICE; nfet_01v8_lvt; 6 x 2 / 0.15 LVT; LVT; M6 gds; M6 cgs; M6 cdg; M2 gds; M2 cgs; M2 cdg; 10 x 2 / 0.3 LVT; M1 gds; M1 cgs; M1 cdg; M9 gds; M9 cgs; M9 cdg; M7 gds; M7 cgs; M7 cdg; v(Voutn); v(Voutp); v(xcmp1.VIq); 3 x 2 / 0.15 LVT; v(xcmp1.Vm8D); pfet_01v8; 1 x 2 / 0.15 LVT; v(xcmp1.VM6D); res_xhigh_po_1p41
