simonwaid/particle_detector/xschem/comp/comp_adv3_di.pdf

# comp_adv3_di.sch

## TT_MODELS

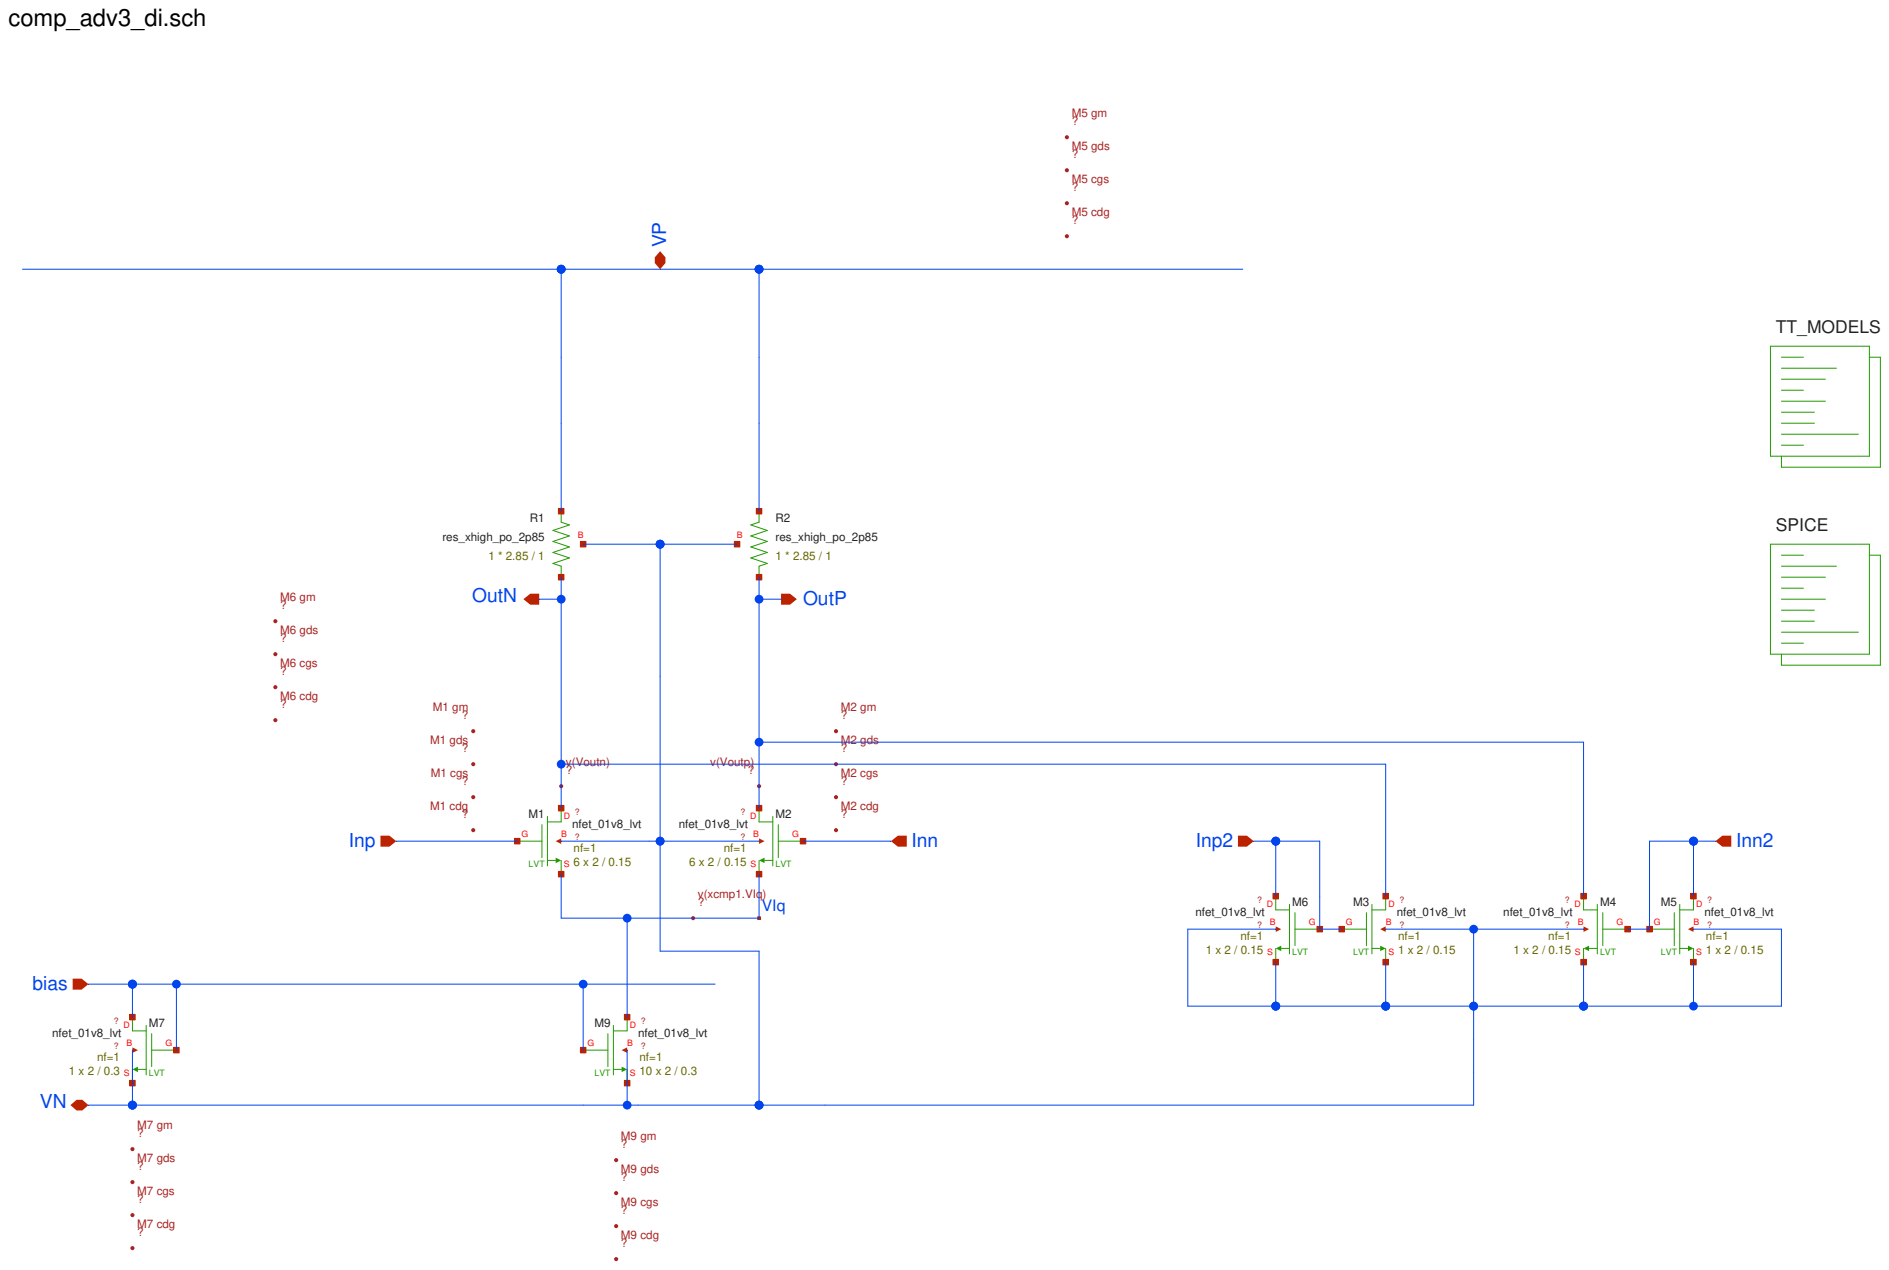
[picture p41: page 1]
VIq; Inp; bias; Inn; OutN; OutP; Inn2Inp2; M5 gds; M5 cgs; M5 cdg; SPICE; nfet_01v8_lvt; LVT; M6 gds; M6 cgs; M6 cdg; M2 gds; M2 cgs; M2 cdg; M1 gds; M1 cgs; M1 cdg; M9 gds; M9 cgs; M9 cdg; M7 gds; M7 cgs; M7 cdg; v(Voutn); v(Voutp); v(xcmp1.VIq); res_xhigh_po_2p85; res_xhigh_po_2p85 B
