simonwaid/particle_detector/xschem/comp/comp_amp_20db.pdf

# comp_amp_20db.sch

VP

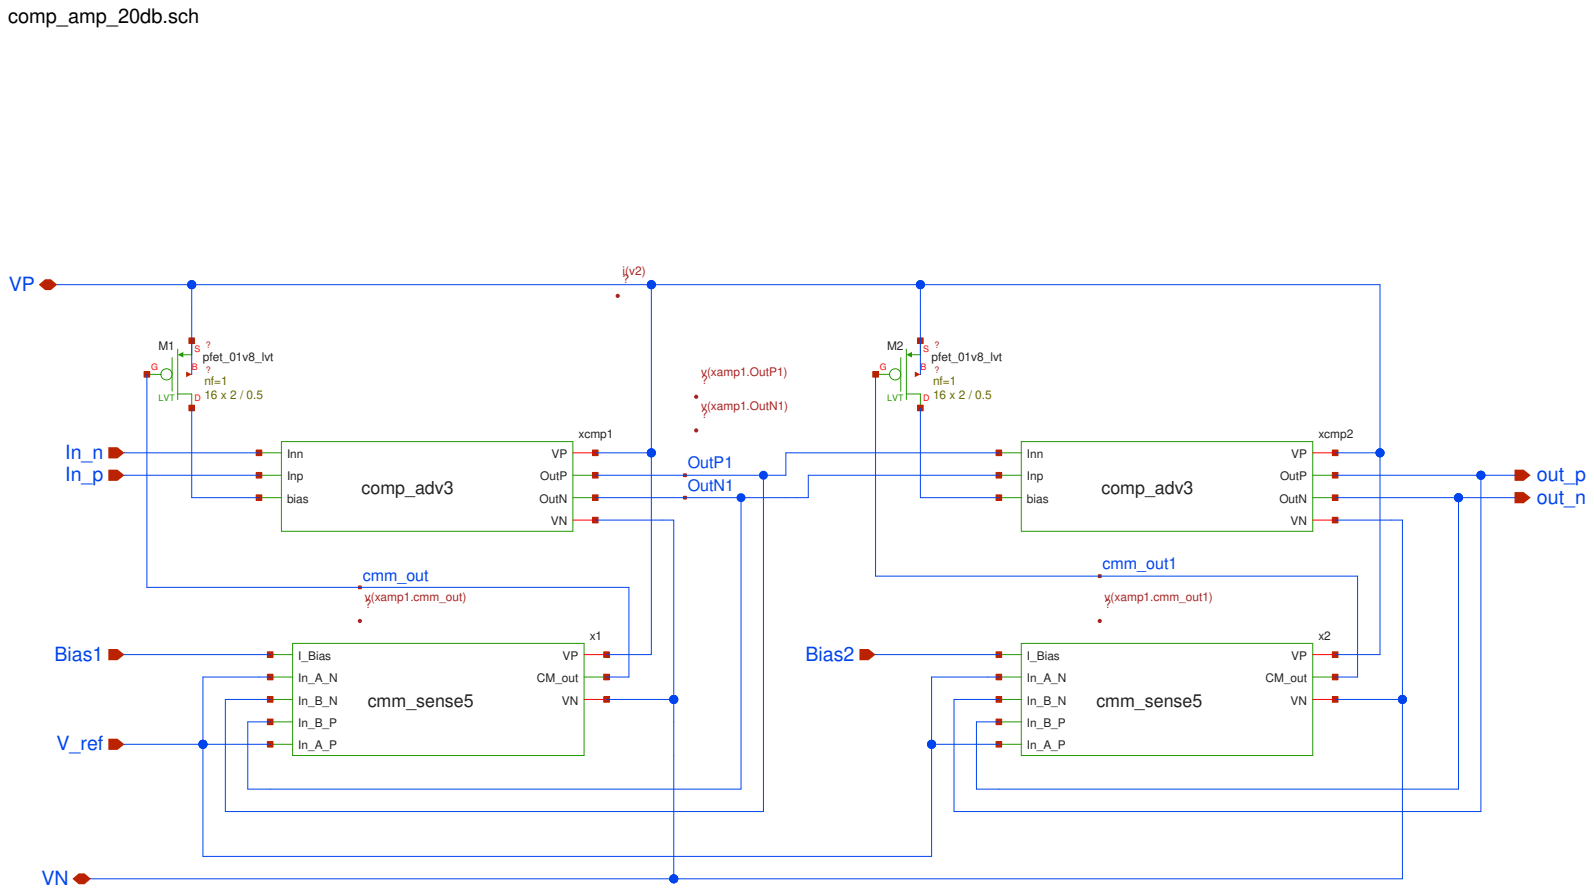
[picture p42: page 1]
OutP1 OutN1; cmm_out; out_p out_n; Bias1; V_ref; Bias2; cmm_out1; comp_adv3; xcmp1; OutP; OutN; Inn; Inp; bias; v(xamp1.OutP1); v(xamp1.OutN1); cmm_sense5; VPI_Bias; CM_outIn_A_N; v(xamp1.cmm_out); xcmp2; v(xamp1.cmm_out1); LVT; pfet_01v8_lvt
