simonwaid/particle_detector/xschem/comp/comp_amp_di_40db.pdf

# comp_amp_di_40db.sch

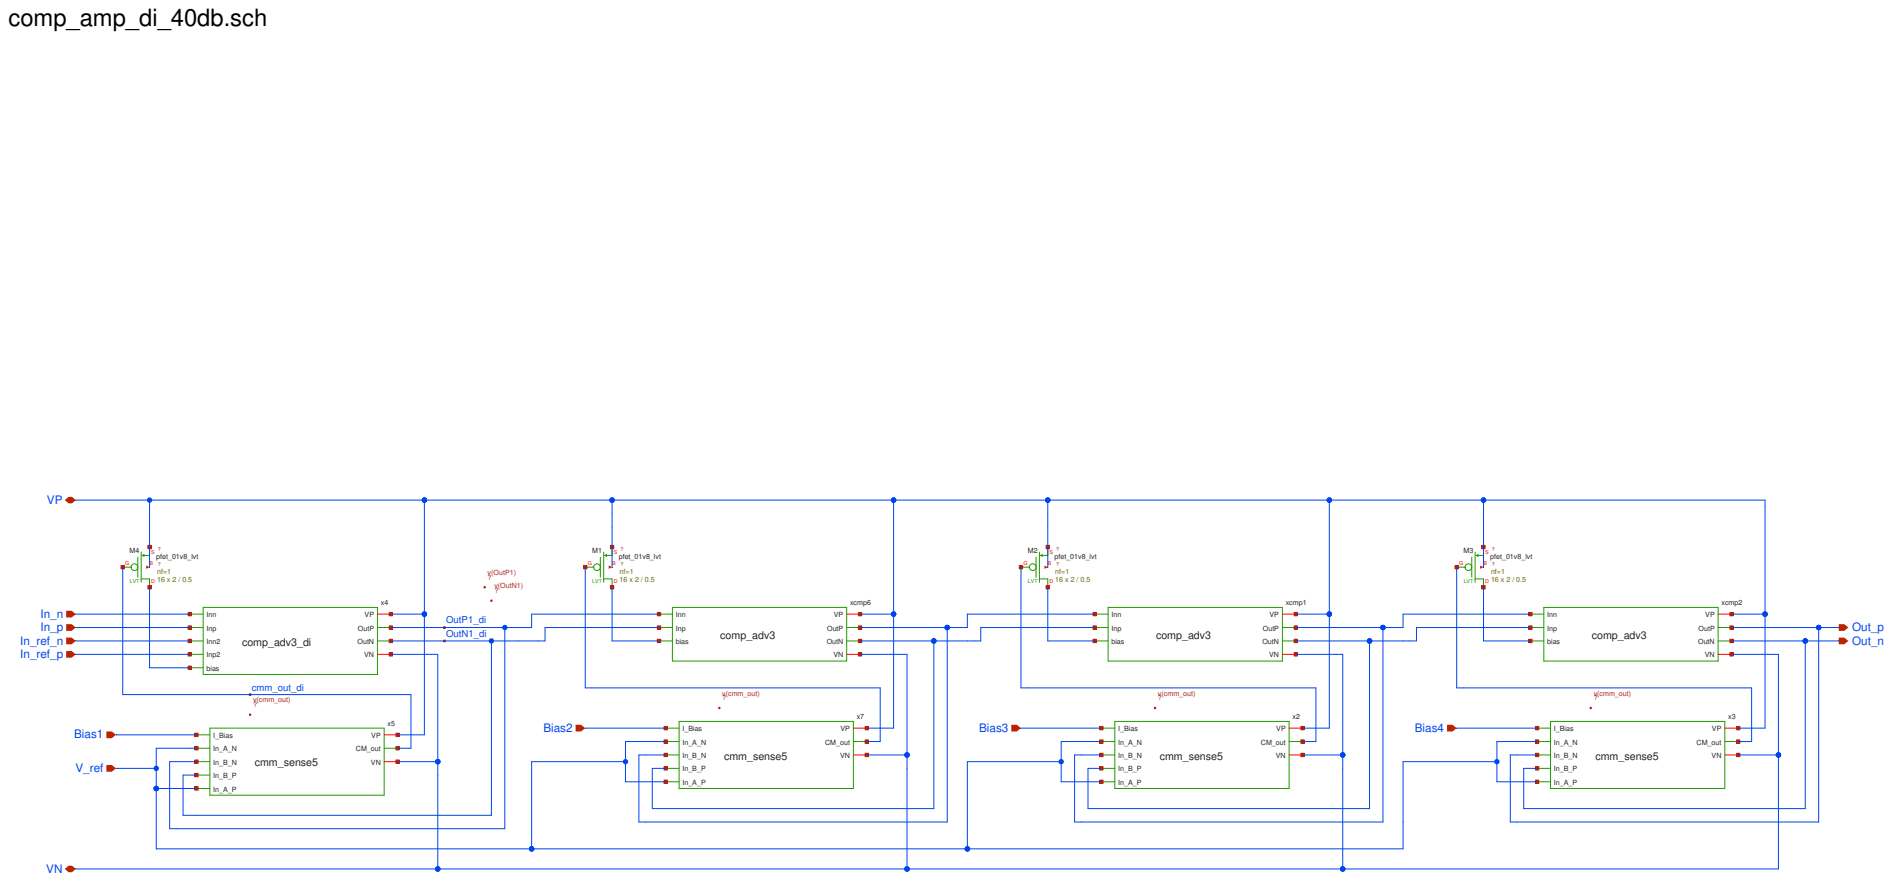
[picture p43: page 1]
OutP1_di OutN1_di; cmm_out_di; Out_pIn_p In_ref_n In_ref_p; Bias1; V_ref; Bias2; Out_n; Bias3; Bias4; comp_adv3_di; OutP; OutN; Inn; Inp; Inn2; Inp2; bias; v(OutP1); v(OutN1); cmm_sense5; VPI_Bias; CM_outIn_A_N; v(cmm_out); comp_adv3; xcmp6; LVT; pfet_01v8_lvt; xcmp1; xcmp2
