simonwaid/particle_detector/xschem/comp/comp_complete.pdf

# comp_complete.sch

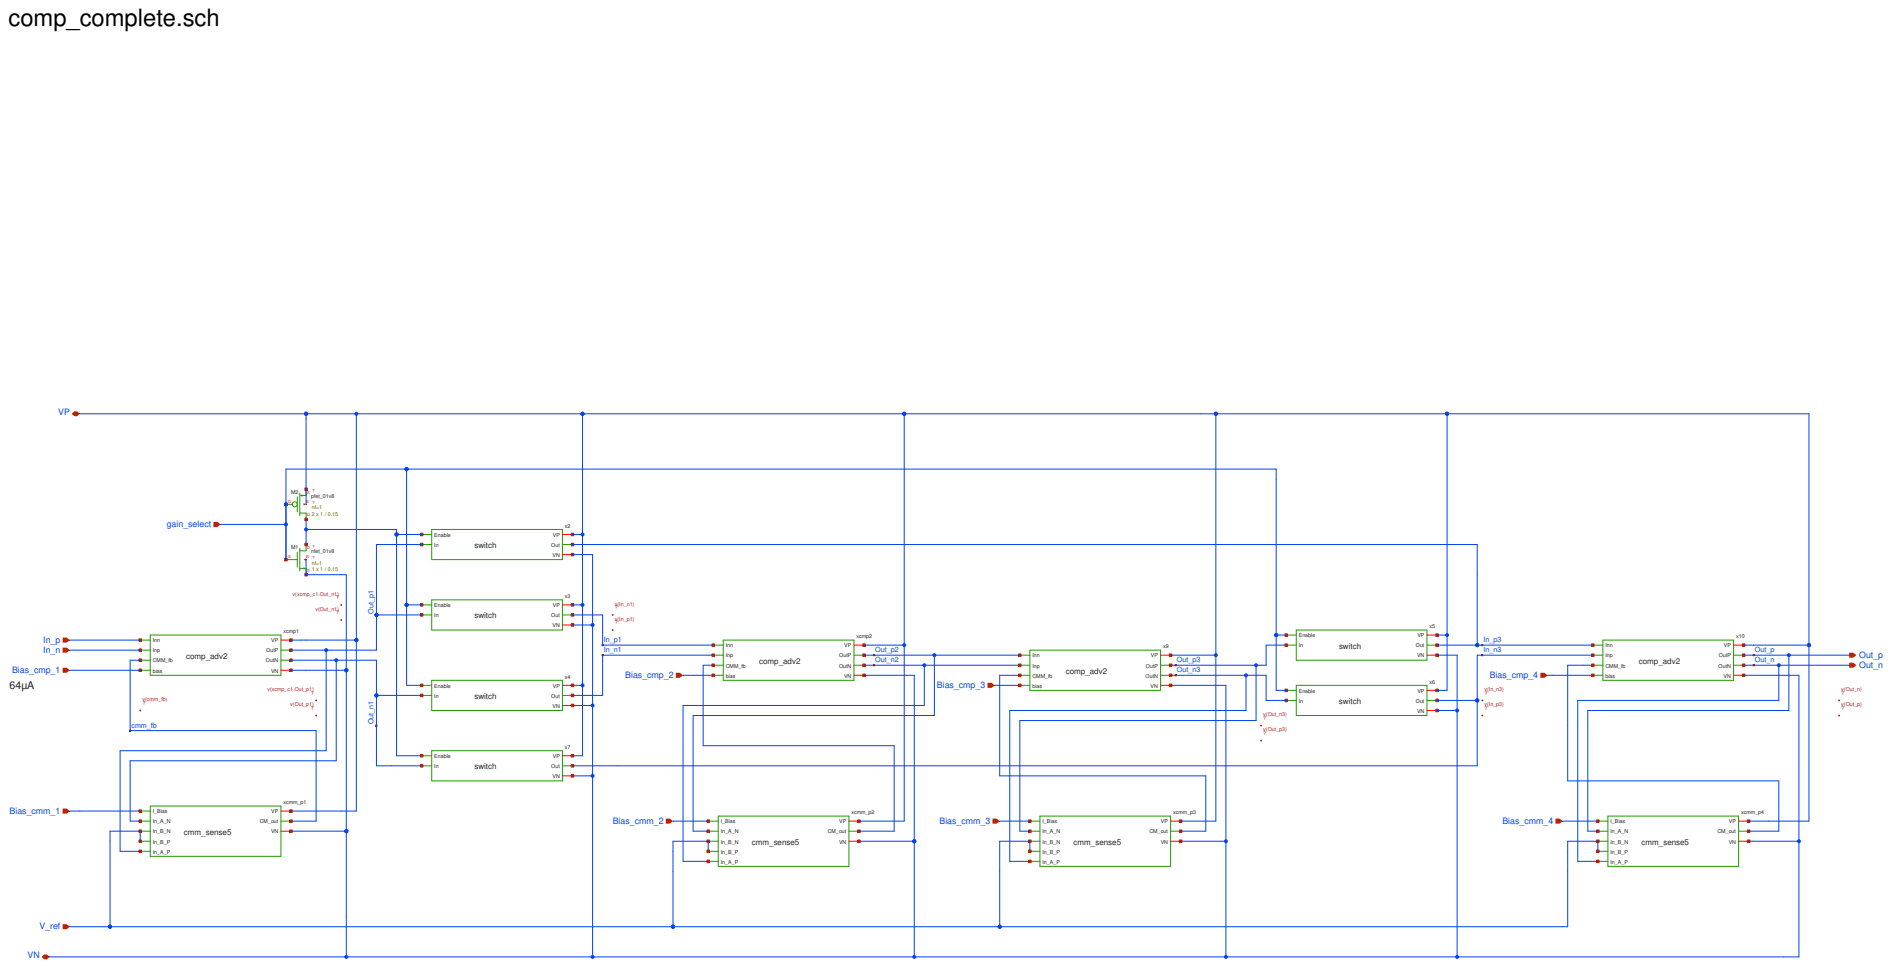
[picture p44: page 1]
Out_p2; Out_n2; Out_p Out_nOut_p3 Out_n3; Out_p1Out_n1; cmm_fb; Out_p; Bias_cmp_1; gain_select; Bias_cmm_1; V_ref; Bias_cmm_2; Bias_cmm_3; Bias_cmp_2; Bias_cmp_3; Bias_cmp_4; Out_n; Bias_cmm_4; v(Out_n1); v(Out_p1); v(Out_n); v(Out_p); switch; VPEnable; OutIn; nfet_01v8; pfet_01v8; v(Out_n3); v(Out_p3); comp_adv2; xcmp1; OutP; OutN; Inn; Inp; CMM_fb; bias; xcmp2; cmm_sense5; xcmm_p1; VPI_Bias; CM_outIn_A_N; v(cmm_fb); xcmm_p2; xcmm_p3; xcmm_p4; v(xcmp_c1.Out_n1); v(xcmp_c1.Out_p1)
