simonwaid/particle_detector/xschem/comp/osch.pdf

# osch.sch

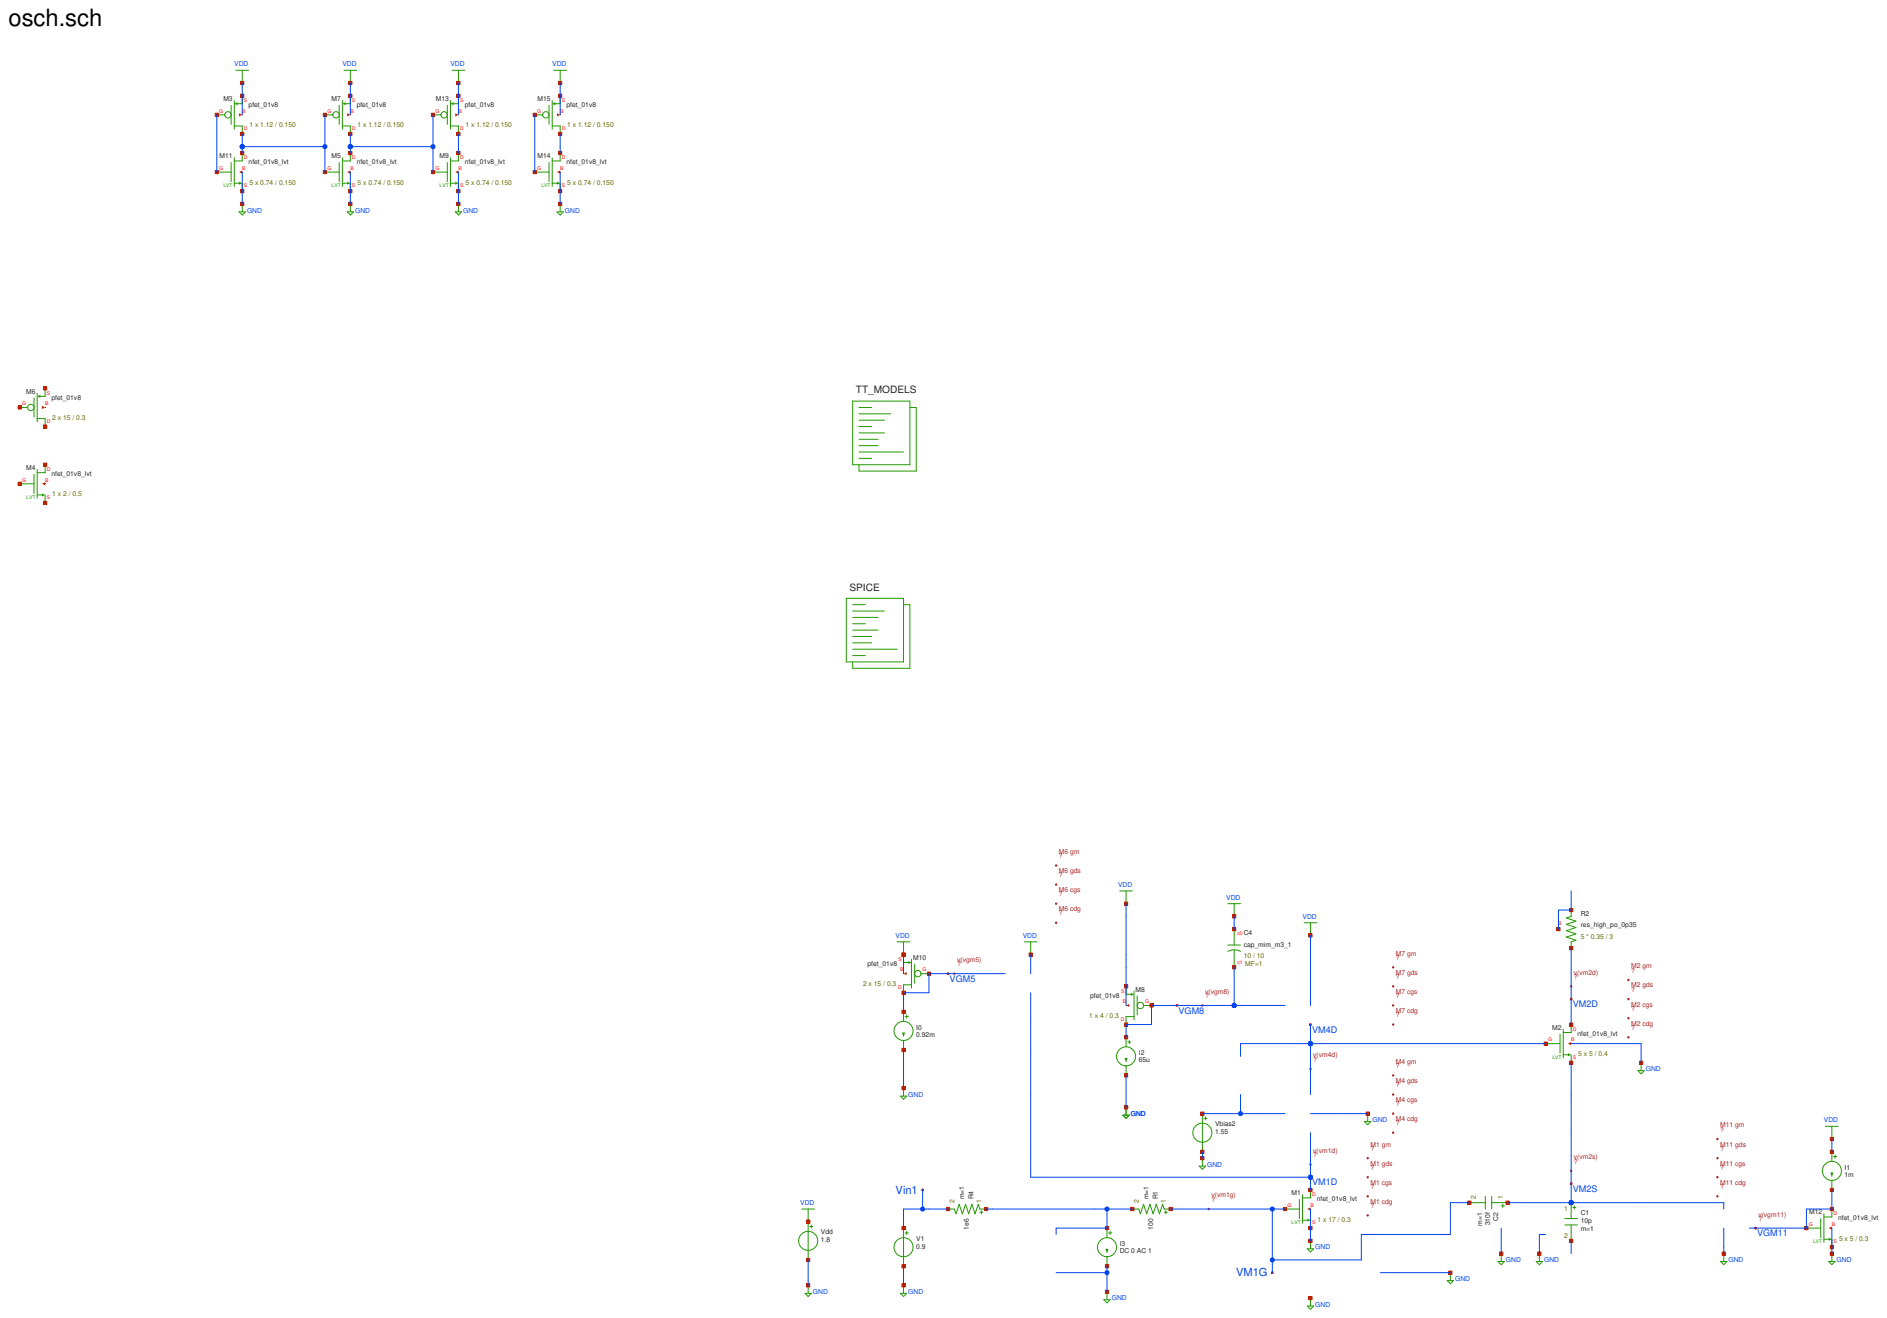
[picture p45: page 1]
VDD; GND; Vin1; VGM8; VGM5; VGM11; Vdd 1.8; TT_MODELS; nfet_01v8_lvt; 1 x 2 / 0.5 LVT; Vbias2 1.55; 1 x 17 / 0.3 LVT; pfet_01v8; M1 gds; M1 cgs; M1 cdg; M4 gds; M4 cgs; M4 cdg; M6 gds; M6 cgs; M6 cdg; M7 gds; M7 cgs; M7 cdg; SPICE; v(vgm8); cap_mim_m3_1; 5 x 5 / 0.4 LVT; res_high_po_0p35 B; M2 gds; M2 cgs; M2 cdg; v(vgm5) R⁴ 1e6; 5 x 0.74 / 0.150 LVT; 5 x 5 / 0.3 LVT; v(vgm11); M11 gds; M11 cgs; M11 cdg
