simonwaid/particle_detector/xschem/comparator_complete.spice

** sch_path: /home/simon/code/particle_detector/xschem/comp/comparator_complete.sch
**.subckt comparator_complete InRef VP Digital_out In Bias_comp1 Bias_comp2 VN Bias_comp4 Bias_comp6
*+ Bias_comp3 Bias_comp5 RefA RefB Bias_to_logic
*.ipin InRef
*.iopin VP
*.opin Digital_out
*.ipin In
*.ipin Bias_comp1
*.ipin Bias_comp2
*.iopin VN
*.ipin Bias_comp4
*.ipin Bias_comp6
*.ipin Bias_comp3
*.ipin Bias_comp5
*.ipin RefA
*.ipin RefB
*.ipin Bias_to_logic
xamp1 VP net1 net2 Outp_20db Bias_comp1 Bias_comp2 Outn_20db VN comp_amp_20db_no_cmm
xl VP Digital_out Outp Outn Bias_to_logic VN comp_to_logic
xamp2 VP net3 Outp_20db Outp RefA Bias_comp4 Bias_comp6 Bias_comp5 Outn RefB Bias_comp3 VN
+ comp_amp_di_40db_no_cmm
XR6 net1 InRef VN sky130_fd_pr__res_xhigh_po_0p35 L=40 mult=1 m=1
XR7 net1 net2 VN sky130_fd_pr__res_xhigh_po_0p35 L=40 mult=1 m=1
XR8 net3 Outp_20db VN sky130_fd_pr__res_xhigh_po_0p35 L=40 mult=1 m=1
XC1 VN net1 sky130_fd_pr__cap_mim_m3_2 W=30 L=20 VM=1 m=1
XC2 net2 In sky130_fd_pr__cap_mim_m3_1 W=5 L=5 MF=1 m=1
XC3 net3 Outn_20db sky130_fd_pr__cap_mim_m3_1 W=5 L=5 MF=1 m=1
**.ends

* expanding   symbol:  comp/comp_amp_20db_no_cmm.sym # of pins=8
** sym_path: /home/simon/code/particle_detector/xschem/comp/comp_amp_20db_no_cmm.sym
** sch_path: /home/simon/code/particle_detector/xschem/comp/comp_amp_20db_no_cmm.sch
.subckt comp_amp_20db_no_cmm  VP In_n In_p out_p Bias1 Bias2 out_n VN
*.ipin In_n
*.ipin In_p
*.iopin VP
*.opin out_p
*.opin out_n
*.ipin Bias1
*.ipin Bias2
*.iopin VN
xcmp2 VP out_p out_n OutP1 OutN1 Bias2 VN comp_adv3
xcmp1 VP OutP1 OutN1 In_n In_p Bias1 VN comp_adv3
.ends


* expanding   symbol:  comp/comp_to_logic.sym # of pins=6
** sym_path: /home/simon/code/particle_detector/xschem/comp/comp_to_logic.sym
** sch_path: /home/simon/code/particle_detector/xschem/comp/comp_to_logic.sch
.subckt comp_to_logic  VP Out In_p In_n I_Bias VN
*.iopin VP
*.iopin VN
*.ipin In_p
*.ipin In_n
*.ipin I_Bias
*.opin Out
XM1 VM1D In_n VM4D VN sky130_fd_pr__nfet_01v8_lvt L=0.15 W=2 nf=1 ad='int((nf+1)/2) * W/nf * 0.29' as='int((nf+2)/2) * W/nf * 0.29'
+ pd='2*int((nf+1)/2) * (W/nf + 0.29)' ps='2*int((nf+2)/2) * (W/nf + 0.29)' nrd='0.29 / W' nrs='0.29 / W'
+ sa=0 sb=0 sd=0 mult=2 m=2
XM2 VM1D VM1D VP VP sky130_fd_pr__pfet_01v8 L=0.15 W=2 nf=1 ad='int((nf+1)/2) * W/nf * 0.29' as='int((nf+2)/2) * W/nf * 0.29'
+ pd='2*int((nf+1)/2) * (W/nf + 0.29)' ps='2*int((nf+2)/2) * (W/nf + 0.29)' nrd='0.29 / W' nrs='0.29 / W'
+ sa=0 sb=0 sd=0 mult=2 m=2
XM4 VM4D I_Bias VN VN sky130_fd_pr__nfet_01v8 L=0.3 W=2 nf=1 ad='int((nf+1)/2) * W/nf * 0.29' as='int((nf+2)/2) * W/nf * 0.29'
+ pd='2*int((nf+1)/2) * (W/nf + 0.29)' ps='2*int((nf+2)/2) * (W/nf + 0.29)' nrd='0.29 / W' nrs='0.29 / W'
+ sa=0 sb=0 sd=0 mult=2*8 m=2*8
XM6 VM6D In_p VM4D VN sky130_fd_pr__nfet_01v8_lvt L=0.15 W=2 nf=1 ad='int((nf+1)/2) * W/nf * 0.29' as='int((nf+2)/2) * W/nf * 0.29'
+ pd='2*int((nf+1)/2) * (W/nf + 0.29)' ps='2*int((nf+2)/2) * (W/nf + 0.29)' nrd='0.29 / W' nrs='0.29 / W'
+ sa=0 sb=0 sd=0 mult=2 m=2
XM7 I_Bias I_Bias VN VN sky130_fd_pr__nfet_01v8 L=0.3 W=2 nf=1 ad='int((nf+1)/2) * W/nf * 0.29' as='int((nf+2)/2) * W/nf * 0.29'
+ pd='2*int((nf+1)/2) * (W/nf + 0.29)' ps='2*int((nf+2)/2) * (W/nf + 0.29)' nrd='0.29 / W' nrs='0.29 / W'
+ sa=0 sb=0 sd=0 mult=2 m=2
XM3 VM6D VM6D VP VP sky130_fd_pr__pfet_01v8 L=0.15 W=2 nf=1 ad='int((nf+1)/2) * W/nf * 0.29' as='int((nf+2)/2) * W/nf * 0.29'
+ pd='2*int((nf+1)/2) * (W/nf + 0.29)' ps='2*int((nf+2)/2) * (W/nf + 0.29)' nrd='0.29 / W' nrs='0.29 / W'
+ sa=0 sb=0 sd=0 mult=2 m=2
XM8 VM11D VM1D VP VP sky130_fd_pr__pfet_01v8 L=0.15 W=2 nf=1 ad='int((nf+1)/2) * W/nf * 0.29' as='int((nf+2)/2) * W/nf * 0.29'
+ pd='2*int((nf+1)/2) * (W/nf + 0.29)' ps='2*int((nf+2)/2) * (W/nf + 0.29)' nrd='0.29 / W' nrs='0.29 / W'
+ sa=0 sb=0 sd=0 mult=4 m=4
XM9 VM12D VM6D VP VP sky130_fd_pr__pfet_01v8 L=0.15 W=2 nf=1 ad='int((nf+1)/2) * W/nf * 0.29' as='int((nf+2)/2) * W/nf * 0.29'
+ pd='2*int((nf+1)/2) * (W/nf + 0.29)' ps='2*int((nf+2)/2) * (W/nf + 0.29)' nrd='0.29 / W' nrs='0.29 / W'
+ sa=0 sb=0 sd=0 mult=4 m=4
XM11 VM11D VM11D VN VN sky130_fd_pr__nfet_01v8 L=0.15 W=2 nf=1 ad='int((nf+1)/2) * W/nf * 0.29' as='int((nf+2)/2) * W/nf * 0.29'
+ pd='2*int((nf+1)/2) * (W/nf + 0.29)' ps='2*int((nf+2)/2) * (W/nf + 0.29)' nrd='0.29 / W' nrs='0.29 / W'
+ sa=0 sb=0 sd=0 mult=3 m=3
XM12 VM12D VM11D VN VN sky130_fd_pr__nfet_01v8 L=0.15 W=2 nf=1 ad='int((nf+1)/2) * W/nf * 0.29' as='int((nf+2)/2) * W/nf * 0.29'
+ pd='2*int((nf+1)/2) * (W/nf + 0.29)' ps='2*int((nf+2)/2) * (W/nf + 0.29)' nrd='0.29 / W' nrs='0.29 / W'
+ sa=0 sb=0 sd=0 mult=3 m=3
XM14 VM17D VM12D VP VP sky130_fd_pr__pfet_01v8 L=0.15 W=2 nf=1 ad='int((nf+1)/2) * W/nf * 0.29' as='int((nf+2)/2) * W/nf * 0.29'
+ pd='2*int((nf+1)/2) * (W/nf + 0.29)' ps='2*int((nf+2)/2) * (W/nf + 0.29)' nrd='0.29 / W' nrs='0.29 / W'
+ sa=0 sb=0 sd=0 mult=2 m=2
XM16 VM13D VM17D VP VP sky130_fd_pr__pfet_01v8 L=0.15 W=2 nf=1 ad='int((nf+1)/2) * W/nf * 0.29' as='int((nf+2)/2) * W/nf * 0.29'
+ pd='2*int((nf+1)/2) * (W/nf + 0.29)' ps='2*int((nf+2)/2) * (W/nf + 0.29)' nrd='0.29 / W' nrs='0.29 / W'
+ sa=0 sb=0 sd=0 mult=4 m=4
XM13 VM13D VM17D VN VN sky130_fd_pr__nfet_01v8_lvt L=0.15 W=2 nf=1 ad='int((nf+1)/2) * W/nf * 0.29' as='int((nf+2)/2) * W/nf * 0.29'
+ pd='2*int((nf+1)/2) * (W/nf + 0.29)' ps='2*int((nf+2)/2) * (W/nf + 0.29)' nrd='0.29 / W' nrs='0.29 / W'
+ sa=0 sb=0 sd=0 mult=2 m=2
XM17 VM17D VM12D VN VN sky130_fd_pr__nfet_01v8 L=0.15 W=2 nf=1 ad='int((nf+1)/2) * W/nf * 0.29' as='int((nf+2)/2) * W/nf * 0.29'
+ pd='2*int((nf+1)/2) * (W/nf + 0.29)' ps='2*int((nf+2)/2) * (W/nf + 0.29)' nrd='0.29 / W' nrs='0.29 / W'
+ sa=0 sb=0 sd=0 mult=1 m=1
XM15 VM6D VM1D VP VP sky130_fd_pr__pfet_01v8 L=0.15 W=0.5 nf=1 ad='int((nf+1)/2) * W/nf * 0.29' as='int((nf+2)/2) * W/nf * 0.29'
+ pd='2*int((nf+1)/2) * (W/nf + 0.29)' ps='2*int((nf+2)/2) * (W/nf + 0.29)' nrd='0.29 / W' nrs='0.29 / W'
+ sa=0 sb=0 sd=0 mult=1 m=1
XM19 Out VM13D VP VP sky130_fd_pr__pfet_01v8 L=0.15 W=2 nf=1 ad='int((nf+1)/2) * W/nf * 0.29' as='int((nf+2)/2) * W/nf * 0.29'
+ pd='2*int((nf+1)/2) * (W/nf + 0.29)' ps='2*int((nf+2)/2) * (W/nf + 0.29)' nrd='0.29 / W' nrs='0.29 / W'
+ sa=0 sb=0 sd=0 mult=4 m=4
XM20 Out VM13D VN VN sky130_fd_pr__nfet_01v8_lvt L=0.15 W=2 nf=1 ad='int((nf+1)/2) * W/nf * 0.29' as='int((nf+2)/2) * W/nf * 0.29'
+ pd='2*int((nf+1)/2) * (W/nf + 0.29)' ps='2*int((nf+2)/2) * (W/nf + 0.29)' nrd='0.29 / W' nrs='0.29 / W'
+ sa=0 sb=0 sd=0 mult=2 m=2
XM5 VM1D VM6D VP VP sky130_fd_pr__pfet_01v8 L=0.15 W=0.5 nf=1 ad='int((nf+1)/2) * W/nf * 0.29' as='int((nf+2)/2) * W/nf * 0.29'
+ pd='2*int((nf+1)/2) * (W/nf + 0.29)' ps='2*int((nf+2)/2) * (W/nf + 0.29)' nrd='0.29 / W' nrs='0.29 / W'
+ sa=0 sb=0 sd=0 mult=1 m=1
XM10 VN VN VN VN sky130_fd_pr__nfet_01v8 L=0.3 W=2 nf=1 ad='int((nf+1)/2) * W/nf * 0.29' as='int((nf+2)/2) * W/nf * 0.29'
+ pd='2*int((nf+1)/2) * (W/nf + 0.29)' ps='2*int((nf+2)/2) * (W/nf + 0.29)' nrd='0.29 / W' nrs='0.29 / W'
+ sa=0 sb=0 sd=0 mult=2 m=2
.ends


* expanding   symbol:  comp/comp_amp_di_40db_no_cmm.sym # of pins=12
** sym_path: /home/simon/code/particle_detector/xschem/comp/comp_amp_di_40db_no_cmm.sym
** sch_path: /home/simon/code/particle_detector/xschem/comp/comp_amp_di_40db_no_cmm.sch
.subckt comp_amp_di_40db_no_cmm  VP In_n In_p Out_p In_Ref_n Bias2 Bias4 Bias3 Out_n In_Ref_p Bias1
+ VN
*.ipin In_n
*.iopin VP
*.opin Out_p
*.ipin In_p
*.ipin Bias1
*.ipin Bias2
*.iopin VN
*.opin Out_n
*.ipin Bias3
*.ipin Bias4
*.ipin In_Ref_n
*.ipin In_Ref_p
xcmp6 VP OutP2_di OutN2_di OutP1_di OutN1_di Bias2 VN comp_adv3
xcmp1 VP OutP3_di OutN3_di OutP2_di OutN2_di Bias3 VN comp_adv3
xcmp2 VP Out_p Out_n OutP3_di OutN3_di Bias4 VN comp_adv3
x1 VP OutP1_di OutN1_di In_n In_p In_Ref_n In_Ref_p Bias1 VN comp_adv3_di
.ends


* expanding   symbol:  comp/comp_adv3.sym # of pins=7
** sym_path: /home/simon/code/particle_detector/xschem/comp/comp_adv3.sym
** sch_path: /home/simon/code/particle_detector/xschem/comp/comp_adv3.sch
.subckt comp_adv3  VP OutP OutN Inn Inp bias VN
*.ipin Inp
*.ipin bias
*.ipin Inn
*.iopin VP
*.iopin VN
*.opin OutN
*.opin OutP
XM1 OutN Inp VIq VN sky130_fd_pr__nfet_01v8_lvt L=0.15 W=2 nf=1 ad='int((nf+1)/2) * W/nf * 0.29' as='int((nf+2)/2) * W/nf * 0.29'
+ pd='2*int((nf+1)/2) * (W/nf + 0.29)' ps='2*int((nf+2)/2) * (W/nf + 0.29)' nrd='0.29 / W' nrs='0.29 / W'
+ sa=0 sb=0 sd=0 mult=6 m=6
XM2 OutP Inn VIq VN sky130_fd_pr__nfet_01v8_lvt L=0.15 W=2 nf=1 ad='int((nf+1)/2) * W/nf * 0.29' as='int((nf+2)/2) * W/nf * 0.29'
+ pd='2*int((nf+1)/2) * (W/nf + 0.29)' ps='2*int((nf+2)/2) * (W/nf + 0.29)' nrd='0.29 / W' nrs='0.29 / W'
+ sa=0 sb=0 sd=0 mult=6 m=6
XM7 bias bias VN VN sky130_fd_pr__nfet_01v8_lvt L=0.3 W=2 nf=1 ad='int((nf+1)/2) * W/nf * 0.29' as='int((nf+2)/2) * W/nf * 0.29'
+ pd='2*int((nf+1)/2) * (W/nf + 0.29)' ps='2*int((nf+2)/2) * (W/nf + 0.29)' nrd='0.29 / W' nrs='0.29 / W'
+ sa=0 sb=0 sd=0 mult=1 m=1
XM9 VIq bias VN VN sky130_fd_pr__nfet_01v8_lvt L=0.3 W=2 nf=1 ad='int((nf+1)/2) * W/nf * 0.29' as='int((nf+2)/2) * W/nf * 0.29'
+ pd='2*int((nf+1)/2) * (W/nf + 0.29)' ps='2*int((nf+2)/2) * (W/nf + 0.29)' nrd='0.29 / W' nrs='0.29 / W'
+ sa=0 sb=0 sd=0 mult=10 m=10
XR1 OutN VP VN sky130_fd_pr__res_xhigh_po_2p85 L=1.5 mult=1 m=1
XR2 OutP VP VN sky130_fd_pr__res_xhigh_po_2p85 L=1.5 mult=1 m=1
XM3 bias VN VN VN sky130_fd_pr__nfet_01v8_lvt L=0.3 W=2 nf=1 ad='int((nf+1)/2) * W/nf * 0.29' as='int((nf+2)/2) * W/nf * 0.29'
+ pd='2*int((nf+1)/2) * (W/nf + 0.29)' ps='2*int((nf+2)/2) * (W/nf + 0.29)' nrd='0.29 / W' nrs='0.29 / W'
+ sa=0 sb=0 sd=0 mult=1 m=1
.ends


* expanding   symbol:  comp/comp_adv3_di.sym # of pins=9
** sym_path: /home/simon/code/particle_detector/xschem/comp/comp_adv3_di.sym
** sch_path: /home/simon/code/particle_detector/xschem/comp/comp_adv3_di.sch
.subckt comp_adv3_di  VP OutP OutN Inn Inp Inn2 Inp2 bias VN
*.ipin Inp
*.ipin bias
*.ipin Inn
*.iopin VP
*.iopin VN
*.opin OutN
*.opin OutP
*.ipin Inn2
*.ipin Inp2
XM1 OutN Inp VIq VN sky130_fd_pr__nfet_01v8_lvt L=0.15 W=2 nf=1 ad='int((nf+1)/2) * W/nf * 0.29' as='int((nf+2)/2) * W/nf * 0.29'
+ pd='2*int((nf+1)/2) * (W/nf + 0.29)' ps='2*int((nf+2)/2) * (W/nf + 0.29)' nrd='0.29 / W' nrs='0.29 / W'
+ sa=0 sb=0 sd=0 mult=6 m=6
XM2 OutP Inn VIq VN sky130_fd_pr__nfet_01v8_lvt L=0.15 W=2 nf=1 ad='int((nf+1)/2) * W/nf * 0.29' as='int((nf+2)/2) * W/nf * 0.29'
+ pd='2*int((nf+1)/2) * (W/nf + 0.29)' ps='2*int((nf+2)/2) * (W/nf + 0.29)' nrd='0.29 / W' nrs='0.29 / W'
+ sa=0 sb=0 sd=0 mult=6 m=6
XM7 bias bias VN VN sky130_fd_pr__nfet_01v8_lvt L=0.3 W=2 nf=1 ad='int((nf+1)/2) * W/nf * 0.29' as='int((nf+2)/2) * W/nf * 0.29'
+ pd='2*int((nf+1)/2) * (W/nf + 0.29)' ps='2*int((nf+2)/2) * (W/nf + 0.29)' nrd='0.29 / W' nrs='0.29 / W'
+ sa=0 sb=0 sd=0 mult=1 m=1
XM9 VIq bias VN VN sky130_fd_pr__nfet_01v8_lvt L=0.3 W=2 nf=1 ad='int((nf+1)/2) * W/nf * 0.29' as='int((nf+2)/2) * W/nf * 0.29'
+ pd='2*int((nf+1)/2) * (W/nf + 0.29)' ps='2*int((nf+2)/2) * (W/nf + 0.29)' nrd='0.29 / W' nrs='0.29 / W'
+ sa=0 sb=0 sd=0 mult=10 m=10
XR1 OutN VP VN sky130_fd_pr__res_xhigh_po_2p85 L=1 mult=1 m=1
XR2 OutP VP VN sky130_fd_pr__res_xhigh_po_2p85 L=1 mult=1 m=1
XM3 OutN Inp2 VN VN sky130_fd_pr__nfet_01v8_lvt L=0.15 W=2 nf=1 ad='int((nf+1)/2) * W/nf * 0.29' as='int((nf+2)/2) * W/nf * 0.29'
+ pd='2*int((nf+1)/2) * (W/nf + 0.29)' ps='2*int((nf+2)/2) * (W/nf + 0.29)' nrd='0.29 / W' nrs='0.29 / W'
+ sa=0 sb=0 sd=0 mult=1 m=1
XM4 OutP Inn2 VN VN sky130_fd_pr__nfet_01v8_lvt L=0.15 W=2 nf=1 ad='int((nf+1)/2) * W/nf * 0.29' as='int((nf+2)/2) * W/nf * 0.29'
+ pd='2*int((nf+1)/2) * (W/nf + 0.29)' ps='2*int((nf+2)/2) * (W/nf + 0.29)' nrd='0.29 / W' nrs='0.29 / W'
+ sa=0 sb=0 sd=0 mult=1 m=1
XM5 Inn2 Inn2 VN VN sky130_fd_pr__nfet_01v8_lvt L=0.15 W=2 nf=1 ad='int((nf+1)/2) * W/nf * 0.29' as='int((nf+2)/2) * W/nf * 0.29'
+ pd='2*int((nf+1)/2) * (W/nf + 0.29)' ps='2*int((nf+2)/2) * (W/nf + 0.29)' nrd='0.29 / W' nrs='0.29 / W'
+ sa=0 sb=0 sd=0 mult=1 m=1
XM6 Inp2 Inp2 VN VN sky130_fd_pr__nfet_01v8_lvt L=0.15 W=2 nf=1 ad='int((nf+1)/2) * W/nf * 0.29' as='int((nf+2)/2) * W/nf * 0.29'
+ pd='2*int((nf+1)/2) * (W/nf + 0.29)' ps='2*int((nf+2)/2) * (W/nf + 0.29)' nrd='0.29 / W' nrs='0.29 / W'
+ sa=0 sb=0 sd=0 mult=1 m=1
XM8 Inp2 VN VN VN sky130_fd_pr__nfet_01v8_lvt L=0.15 W=2 nf=1 ad='int((nf+1)/2) * W/nf * 0.29' as='int((nf+2)/2) * W/nf * 0.29'
+ pd='2*int((nf+1)/2) * (W/nf + 0.29)' ps='2*int((nf+2)/2) * (W/nf + 0.29)' nrd='0.29 / W' nrs='0.29 / W'
+ sa=0 sb=0 sd=0 mult=1 m=1
XM10 Inn2 VN VN VN sky130_fd_pr__nfet_01v8_lvt L=0.15 W=2 nf=1 ad='int((nf+1)/2) * W/nf * 0.29' as='int((nf+2)/2) * W/nf * 0.29'
+ pd='2*int((nf+1)/2) * (W/nf + 0.29)' ps='2*int((nf+2)/2) * (W/nf + 0.29)' nrd='0.29 / W' nrs='0.29 / W'
+ sa=0 sb=0 sd=0 mult=1 m=1
XM11 bias VN VN VN sky130_fd_pr__nfet_01v8_lvt L=0.3 W=2 nf=1 ad='int((nf+1)/2) * W/nf * 0.29' as='int((nf+2)/2) * W/nf * 0.29'
+ pd='2*int((nf+1)/2) * (W/nf + 0.29)' ps='2*int((nf+2)/2) * (W/nf + 0.29)' nrd='0.29 / W' nrs='0.29 / W'
+ sa=0 sb=0 sd=0 mult=1 m=1
.ends

.end
