simonwaid/particle_detector/(commit log)

2022-06-09 main layout LVS clean
    [feedback_sukwani.sch, mpw6_submission.sch]
2022-06-09 Ready for precheck
    [esd_diodes.sch, user_analog_project_wrapper.sch]
2022-06-10 Updated documentation
    [user_analog_project_wrapper.sch]
